wyolum/TinyTiM/README.md

TinyTiM
=======

small brother to TiM
8x8 WS2811 RGB LED Matrix
Data Input can be Serial (1 input - DI_A) or Parallel (8 inputs - DI_A thru' DI_H)
Boards can be daisy-chained in Serial or Parallel Mode (Limited to Power Supply capacity and Microcontroller capability)

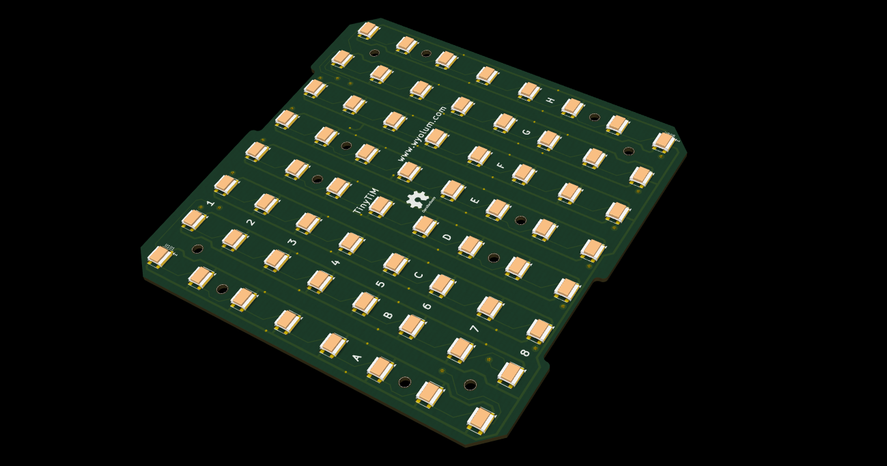
[picture p1: KiCad/rev3/TinyTiM_Images/TinyTiM_rev3_04.png]
TinyTiM top


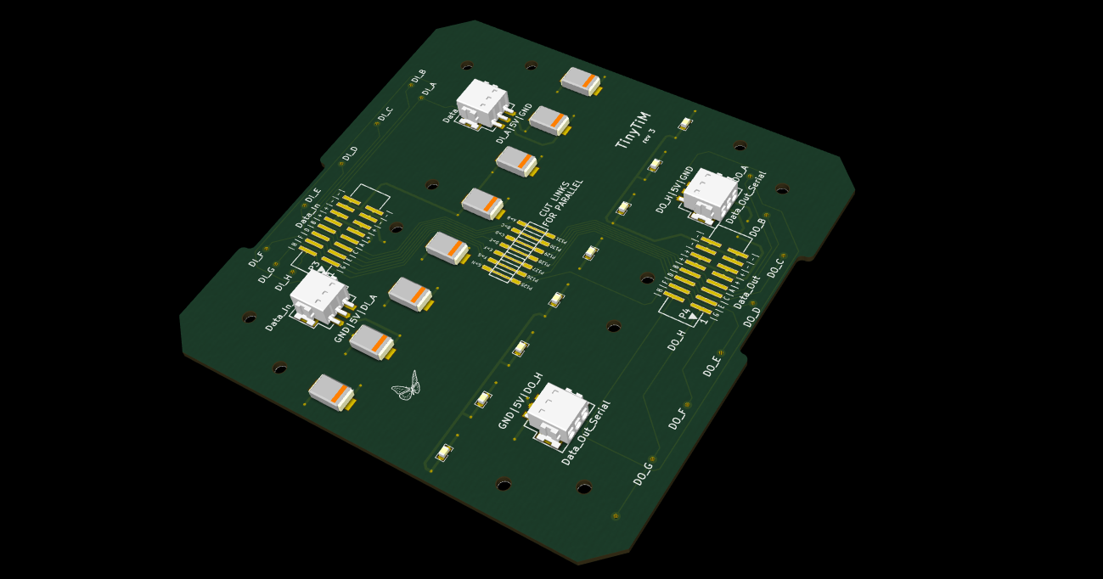
[picture p2: KiCad/rev3/TinyTiM_Images/TinyTiM_rev3_03.png]
TinyTiM bottom


to view 3D render correctly, create a sym_link as follows :

sudo ln -s /home/USER_NAME/projects-git/TinyTiM/KiCad/TinyTiM_3D /usr/share/kicad/modules/packages3d

License
-------
[CERN Open Hardware Licence v1.2 ]

[CERN Open Hardware Licence v1.2 ]:http://www.ohwr.org/attachments/2388/cern_ohl_v_1_2.txt
