wyolum/TinyTiM/KiCad/uTiM/PCB Technology Requirement Format V1 for TinyTim_rev3.xlsx

深圳矽递科技有限公司 Seeed Technology Limited
PCB Technology Requirement Format
PCB Name & Version | TinyTim_rev3
PCB Material PCB板材： | (Rigid)FR－4
PCB Size PCB大小： | inch | ( 4.80 ) × (4.80 )
PCB Layer PCB层数： | 2
Thickness PCB厚度：
 | 1mm
Copper Weight 铜厚： |  | 2oz
PCB Colour 阻焊颜色：
 |  |  | other:( CLEAR )
Silkscreen 字符颜色： |  | Black 黑色 | other:( )
Pads Finished 焊盘喷镀： | (Hasl-lead free) 无铅喷锡
Via solder mask 阻焊覆盖： |  | solder mask opening 过孔开窗
Minimum trace/space (mm) 最小线宽 |  | Minimum hole size (mm) 最小孔径
Special requirements 特殊工艺： | Yes | (Put requirements here)
Comment: | NOTE : SILK SCREEN is ONLY on BOTTOM Layer. FRONT Layer NO SILKSCREEN
