wyolum/TinyTiM/KiCad/rev2/PCB Technology Requirement Format V1 for TinyTim.xlsx

深圳矽递科技有限公司 Seeed Technology Limited
PCB Technology Requirement Format
PCB Name & Version | Tiny Tim
PCB Material PCB板材： | (Rigid)FR－4 | Flex
PCB Size PCB大小： | cm mm inch | ( ) × ( )
PCB Layer PCB层数： | 2 | 4 | other:( )
Thickness PCB厚度： | 0.8mm | 1.2mm | other:( )
 | 1mm | 1.6mm
Copper Weight 铜厚： | 1oz | 2oz | other:( )
PCB Colour 阻焊颜色： | Green 绿色 | White 白色 | Black 黑色
 | Red 红色 | Blue 蓝色 | other:( )
Silkscreen 字符颜色： | White 白色 | Black 黑色 | other:( )
Pads Finished 焊盘喷镀： | (Hasl-lead free) 无铅喷锡 | (Hasl) 含铅喷锡 | (ENIG) 沉镍金
Via solder mask 阻焊覆盖： | solder mask cover 过孔盖油 | solder mask opening 过孔开窗
Minimum trace/space (mm) 最小线宽 |  | Minimum hole size (mm) 最小孔径
Special requirements 特殊工艺： | Yes | (Put requirements here)
Comment:
