wyolum/TinyTiM/KiCad/uTiM/TinyTiM_BOM_sch.csv

Reference | Value | Footprint | Datasheet | Field4 | Field5 | Field6 | manf# | Field7 | Field8 | Field9 | Field10 | Field11
L101 | OSHW | TinyTiM_Lib:OSHW_6mm
L102 | Wyolum | TinyTiM_Libs:logo_wyo_butterfly
P1 | Input1 | TinyTiM_Libs:header_3pos_smd_male |  | CONN HEADER 50POS .100" SGL GOLD | Header | Unshrouded | Male pin |  | 0.1"
P2 | Output1 | TinyTiM_Libs:header_3pos_smd_male |  | CONN HEADER 50POS .100" SGL GOLD | Header | Unshrouded | Male pin |  | 0.1"
P5 | Input2 | TinyTiM_Libs:header_3pos_smd_male |  | CONN HEADER 50POS .100" SGL GOLD | Header | Unshrouded | Male pin |  | 0.1"
P6 | Output2 | TinyTiM_Libs:header_3pos_smd_male |  | CONN HEADER 50POS .100" SGL GOLD | Header | Unshrouded | Male pin |  | 0.1"
P3 | 5V | TinyTiM_Libs:PowerIn_stud |  |  |  |  | mfr_pn
P4 | GND | TinyTiM_Libs:PowerIn_stud |  |  |  |  | mfr_pn
L103 | Maniacal Labs | TinyTiM_Libs:logo_MLlabs
U57 | APA102 | TinyTiM_Libs:APA102 |  |  |  |  | mfr_pn
C3 | 100n | TinyTiM_Libs:c_0805 |  | CAP CER 0.1UF 25V 10% X7R 0805 | 100nF | 25V | Surface Mount | MLCC | Value | Kemet | C0805C104K3RACTU | Digikey | 399-1168-1-ND | http://www.digikey.com/product-detail/en/C0805C104K3RACTU/399-1168-1-ND/411443
C4 | 47u | 8V | TinyTiM_Libs:c_2917 |  | CAP ALUM 47UF 8V 20% SMD | 47u | 8V | 2917 (7343 Metric) | Value | Panasonic Electronic Components | EEF-CD0K470R | Digikey | PCE3606CT-ND | http://www.digikey.com/product-detail/en/EEF-CD0K470R/PCE3606CT-ND/614442
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
U04 | APA102 | TinyTiM_Libs:APA102 |  |  |  |  | mfr_pn
U05 | APA102 | TinyTiM_Libs:APA102 |  |  |  |  | mfr_pn
U06 | APA102 | TinyTiM_Libs:APA102 |  |  |  |  | mfr_pn
U07 | APA102 | TinyTiM_Libs:APA102 |  |  |  |  | mfr_pn
U08 | APA102 | TinyTiM_Libs:APA102 |  |  |  |  | mfr_pn
