wyolum/TinyTiM/KiCad/uTiM/TinyTiM_BoM_rev3.ods

Sheet: BoM_PCB
Id | Value | Reference | Quantity | Package | Supplier and ref
1 | 100n | C101,C201,C301,C401,C501,C601,C701,C801 | 8 | TinyTiM_Lib:c_0805
2 | 47u,8V | C117,C217,C317,C417,C517,C617,C717,C817 | 8 | TinyTiM_Lib:c_2917
5 | Data_In_Serial | P5 | 1 | TinyTiM_Lib:Conn_x3_PTSM
6 | Data_Out_Serial | P6 | 1 | TinyTiM_Lib:Conn_x3_PTSM
7 | Data_In_Serial | P1 | 1 | TinyTiM_Lib:Conn_x2_PTSM
8 | Data_Out_Serial | P2 | 1 | TinyTiM_Lib:Conn_x2_PTSM
20 | RGB_WS2811B | U808,U807,U806,U805,U804,U803,U802,U801,U708,U707,U706,U705,U704,U703,U702,U701,U608,U607,U606,U605,U604,U603,U602,U601,U508,U507,U506,U505,U504,U503,U502,U501,U408,U407,U406,U405,U404,U403,U402,U401,U308,U307,U306,U305,U304,U303,U302,U301,U208,U207,U206,U205,U204,U203,U202,U201,U108,U107,U106,U105,U104,U103,U102,U101 | 64 | TinyTiM_Lib:RGB_WS2811
3 | Wyolum | L102 | 1 | TinyTiM_Lib:Logo-WL3
4 | OSHW | L101 | 1 | TinyTiM_Lib:OSHW_6mm
11 | G>H | P125 | 1 | TinyTiM_Lib:ShortLink2
12 | F>G | P126 | 1 | TinyTiM_Lib:ShortLink2
13 | E>F | P127 | 1 | TinyTiM_Lib:ShortLink2
14 | D>E | P128 | 1 | TinyTiM_Lib:ShortLink2
15 | C>D | P129 | 1 | TinyTiM_Lib:ShortLink2
16 | B>C | P130 | 1 | TinyTiM_Lib:ShortLink2
17 | A>B | P131 | 1 | TinyTiM_Lib:ShortLink2
18 | CONN_1 | PCB101 | 1 | TinyTiM_Lib:PCB
19 | CONN_1 | S101,S102,S401,S402,S501,S502,S801,S802,S103,S104,S803,S804 | 12 | TinyTiM_Lib:Screw
9 | Data_In | P3 | 1 | TinyTiM_Lib:Header_8x2
10 | Data_Out | P4 | 1 | TinyTiM_Lib:Header_8x2

Sheet: BoM_SCH
Id | Value | Reference | Quantity
1 | 100n | C101 C201 C301 C401 C501 C601 C701 C801 | 8
2 | 47u,8V | C117 C217 C317 C417 C517 C617 C717 C817 | 8
5 | Data_In_Serial | P5 | 1
6 | Data_Out_Serial | P6 | 1
7 | Data_In_Serial | P1 | 1
8 | Data_Out_Serial | P2 | 1
9 | Data_In | P3 | 1
10 | Data_Out | P4 | 1
20 | RGB_WS2811B | U101 U102 U103 U104 U105 U106 U107 U108 U201 U202 U203 U204 U205 U206 U207 U208 U301 U302 U303 U304 U305 U306 U307 U308 U401 U402 U403 U404 U405 U406 U407 U408 U501 U502 U503 U504 U505 U506 U507 U508 U601 U602 U603 U604 U605 U606 U607 U608 U701 U702 U703 U704 U705 U706 U707 U708 U801 U802 U803 U804 U805 U806 U807 U808 | 64
3 | Wyolum | L102 | 1
4 | OSHW | L101 | 1
11 | G>H | P125 | 1
12 | F>G | P126 | 1
13 | E>F | P127 | 1
14 | D>E | P128 | 1
15 | C>D | P129 | 1
16 | B>C | P130 | 1
17 | A>B | P131 | 1
18 | CONN_1 | PCB101 | 1
19 | CONN_1 | S101 S102 S103 S104 S401 S402 S501 S502 S801 S802 S803 S804 | 12

Sheet: BoM_TinyTiM
Id | Reference | Quantity | Value
1 | C101 C201 C301 C401 C501 C601 C701 C801 | 8 | 100n
2 | C117 C217 C317 C417 C517 C617 C717 C817 | 8 | 47u,8V
5 | P5 | 1 | Data_In_Serial
6 | P6 | 1 | Data_Out_Serial
7 | P1 | 1 | Data_In_Serial
8 | P2 | 1 | Data_Out_Serial
9 | P3 | 1 | Data_In
10 | P4 | 1 | Data_Out
20 | U101 U102 U103 U104 U105 U106 U107 U108 U201 U202 U203 U204 U205 U206 U207 U208 U301 U302 U303 U304 U305 U306 U307 U308 U401 U402 U403 U404 U405 U406 U407 U408 U501 U502 U503 U504 U505 U506 U507 U508 U601 U602 U603 U604 U605 U606 U607 U608 U701 U702 U703 U704 U705 U706 U707 U708 U801 U802 U803 U804 U805 U806 U807 U808 | 64 | RGB_WS2811B
