wyolum/TinyTiM/KiCad/uTiM/TinyTiM.FCStd

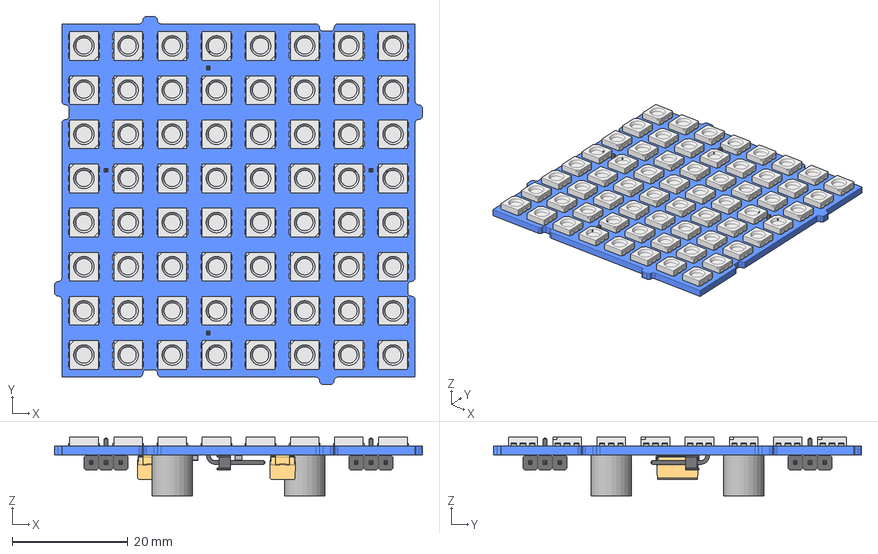
[picture p3: CAD file, 2016-02-17]
KiCad/uTiM/TinyTiM.FCStd
63.5 x 63.5 x 10.1 mm
Pcb
User_Library-CapCeramic_Kemet_0805_2012_
User_Library-CapCeramic_Kemet_0805_2012_001
Draft_
Draft_001
Draft_002
Draft_003
Draft_004
Draft_005
Draft_006
Draft_007
Draft_008
Draft_009
Draft_010
Draft_011
Draft_012
Draft_013
Draft_014
Draft_015
Draft_016
Draft_017
Draft_018
Draft_019
Draft_020
Draft_021
Draft_022
Draft_023
Draft_024
Draft_025
Draft_026
Draft_027
Draft_028
Draft_029
Draft_030
Draft_031
Draft_032
Draft_033
Draft_034
Draft_035
Draft_036
Draft_037
Draft_038
Draft_039
Draft_040
Draft_041
Draft_042
Draft_043
Draft_044
Draft_045
Draft_046
Draft_047
Draft_048
Draft_049
Draft_050
Draft_051
Draft_052
Draft_053
Draft_054
Draft_055
Draft_056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
