wyolum/TinyTiM/KiCad/uTiM/TinyTiM_3D/Cap_2917_AVX_E_CASE.step

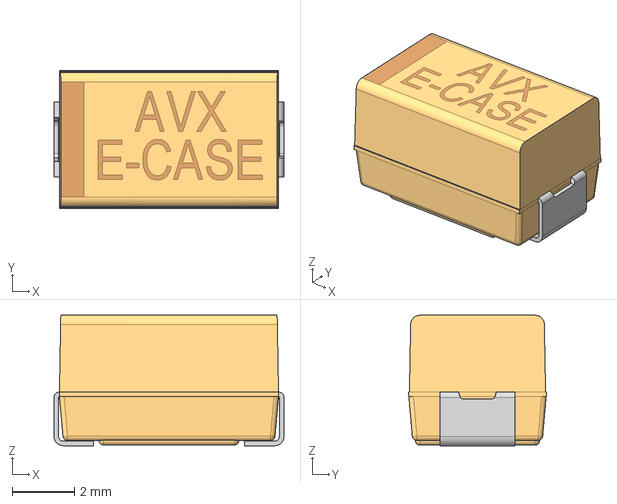
[picture p4: CAD file, 2016-02-17]
KiCad/uTiM/TinyTiM_3D/Cap_2917_AVX_E_CASE.step
7.40 x 4.45 x 4.20 mm
