wyolum/TinyTiM/KiCad/uTiM/TinyTiM1.FCStd

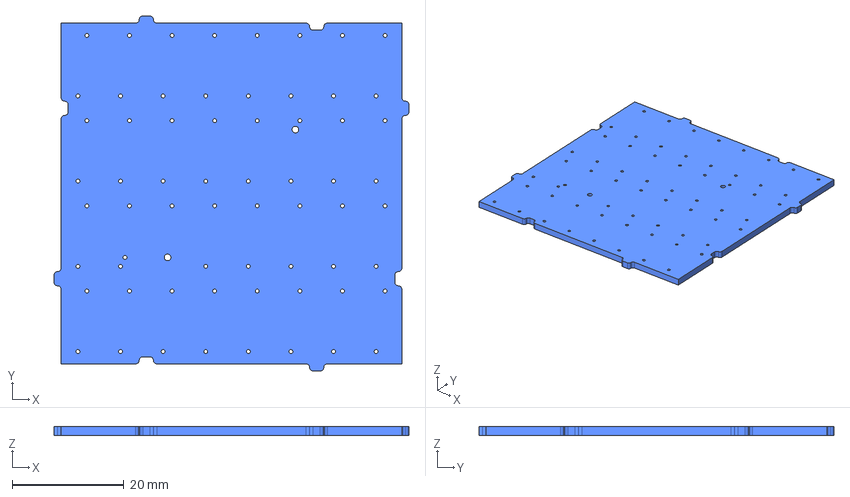
[picture p5: CAD file, 2016-02-17]
KiCad/uTiM/TinyTiM1.FCStd
63.5 x 63.5 x 1.60 mm
