wyolum/TinyTiM/KiCad/uTiM/TinyTiM_3D/header_a-sl200-da-g06mp1.step

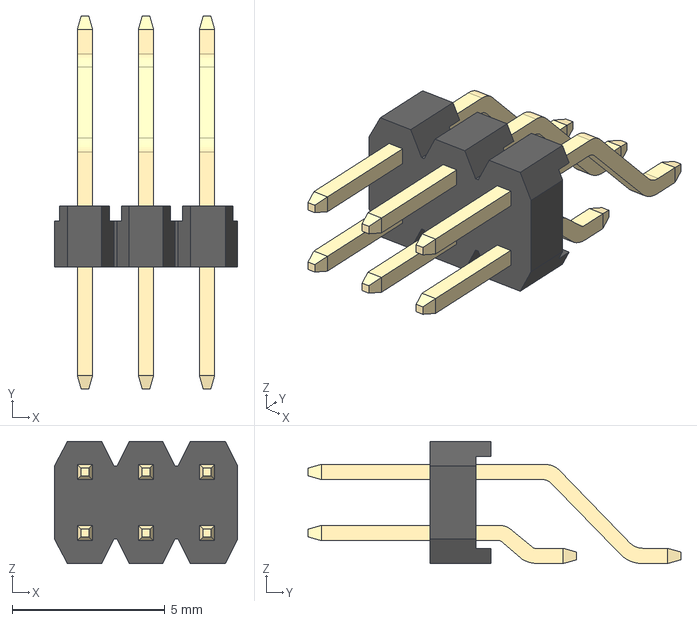
[picture p6: CAD file, 2016-02-16]
KiCad/uTiM/TinyTiM_3D/header_a-sl200-da-g06mp1.step
6.00 x 12.2 x 4.00 mm
