wyolum/TinyTiM/KiCad/uTiM/TinyTiM_3D/header1x3_1241150-3.step

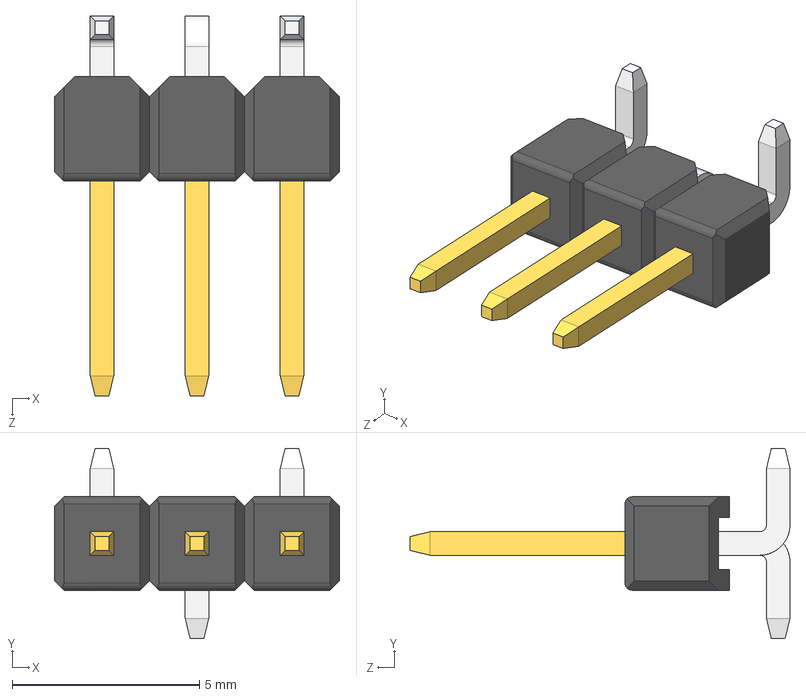
[picture p7: CAD file, 2016-02-16]
KiCad/uTiM/TinyTiM_3D/header1x3_1241150-3.step
7.62 x 5.08 x 10.2 mm
