wyolum/TinyTiM/KiCad/uTiM/TinyTiM_3D/header_Male_RA_Low_3Pin.step

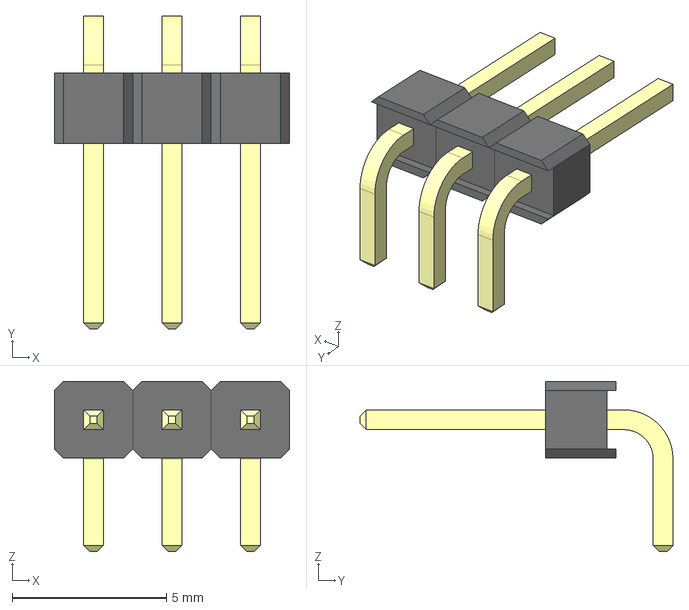
[picture p8: CAD file, 2016-02-16]
KiCad/uTiM/TinyTiM_3D/header_Male_RA_Low_3Pin.step
7.62 x 10.1 x 5.52 mm
