wyolum/TinyTiM/KiCad/uTiM/TinyTiM_3D/BM03B-SRSS-TB.step

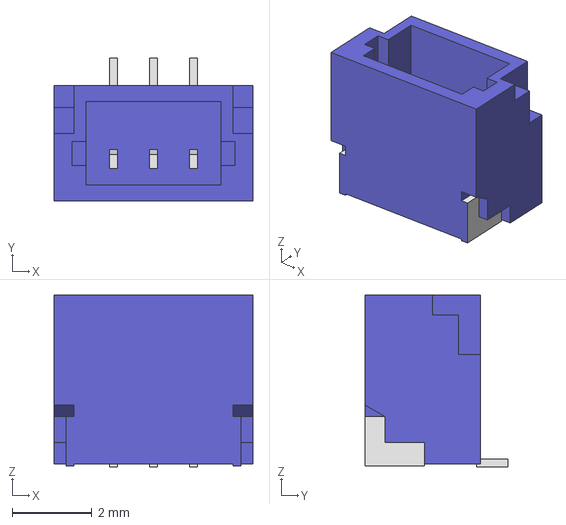
[picture p9: CAD file, 2016-02-15]
KiCad/uTiM/TinyTiM_3D/BM03B-SRSS-TB.step
5.00 x 3.60 x 4.32 mm
