wyolum/TinyTiM/KiCad/uTiM/TinyTiM_3D/PowerIn_Stud.step

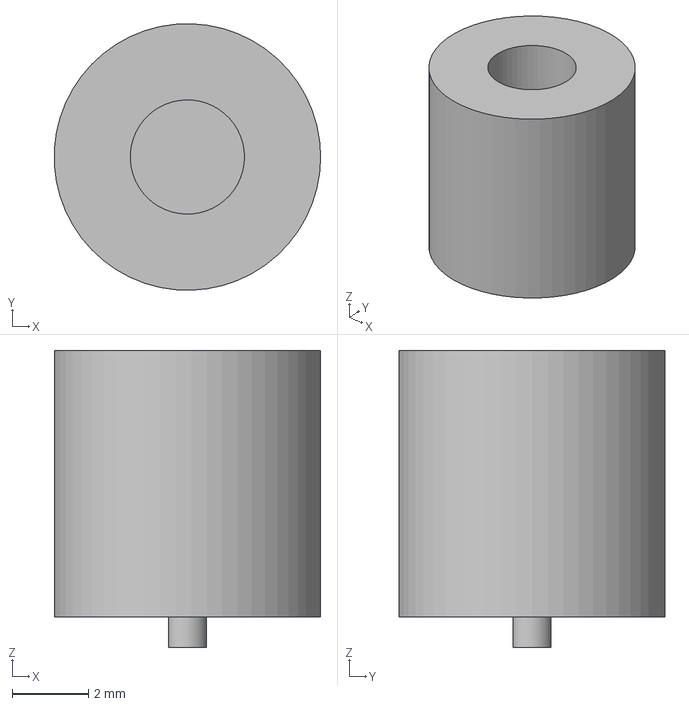
[picture p10: CAD file, 2016-02-15]
KiCad/uTiM/TinyTiM_3D/PowerIn_Stud.step
6.99 x 7.00 x 7.80 mm
