wyolum/TinyTiM/KiCad/uTiM/TinyTiM_3D/Cap_0805_2012.step

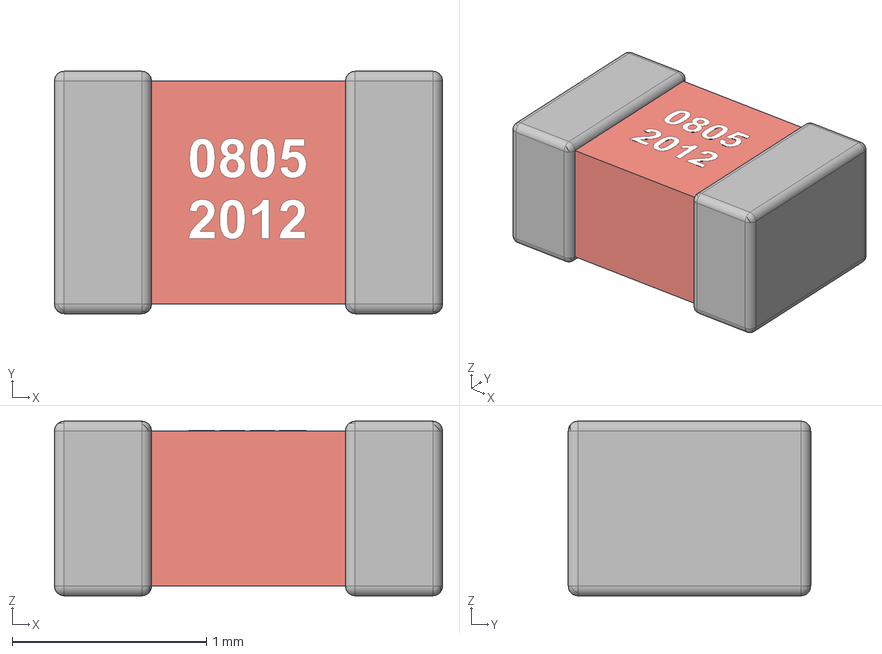
[picture p11: CAD file, 2016-02-15]
KiCad/uTiM/TinyTiM_3D/Cap_0805_2012.step
2.00 x 1.25 x 0.9 mm
