wyolum/TinyTiM/KiCad/uTiM/TinyTiM_3D/LED_SMD_APA102.step

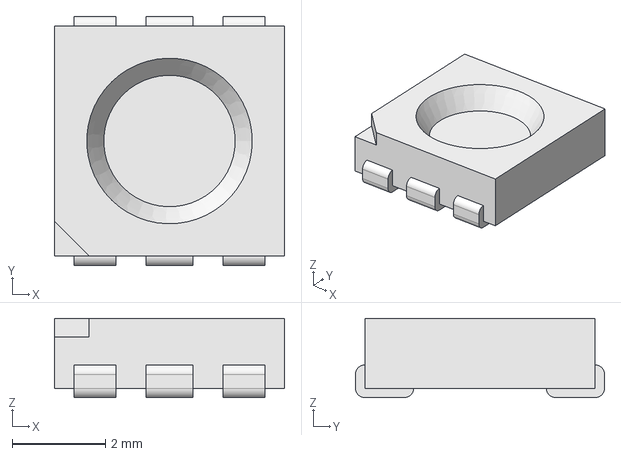
[picture p12: CAD file, 2016-02-15]
KiCad/uTiM/TinyTiM_3D/LED_SMD_APA102.step
4.95 x 5.35 x 1.70 mm
