wyolum/TinyTiM/KiCad/uTiM/TinyTiM_3D/conn_1771033.stp

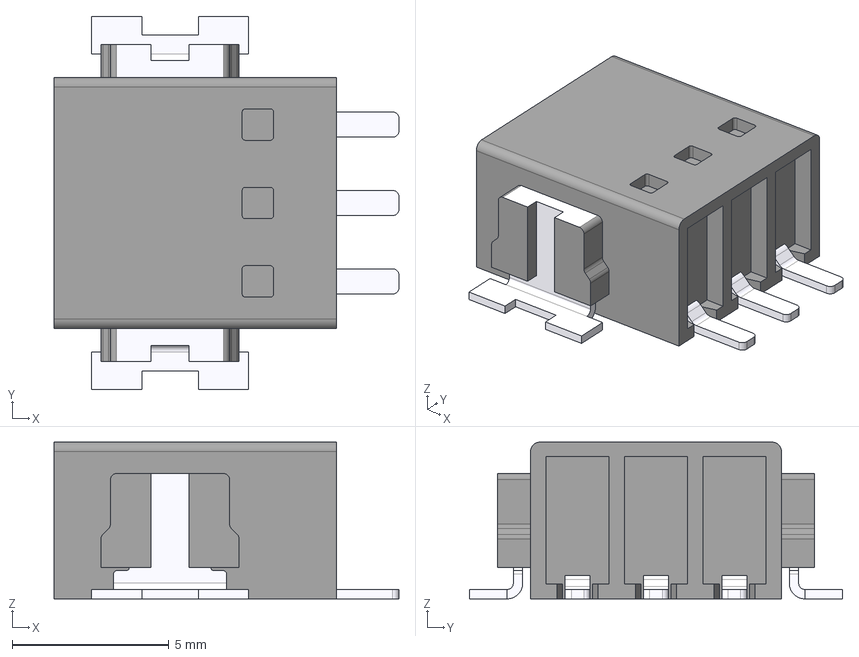
[picture p13: CAD file, 2016-02-15]
KiCad/uTiM/TinyTiM_3D/conn_1771033.stp
11.0 x 11.9 x 5.00 mm
