wyolum/TinyTiM/KiCad/rev1/TinyTiM_3D/User Library-20-pin SMT header.stl

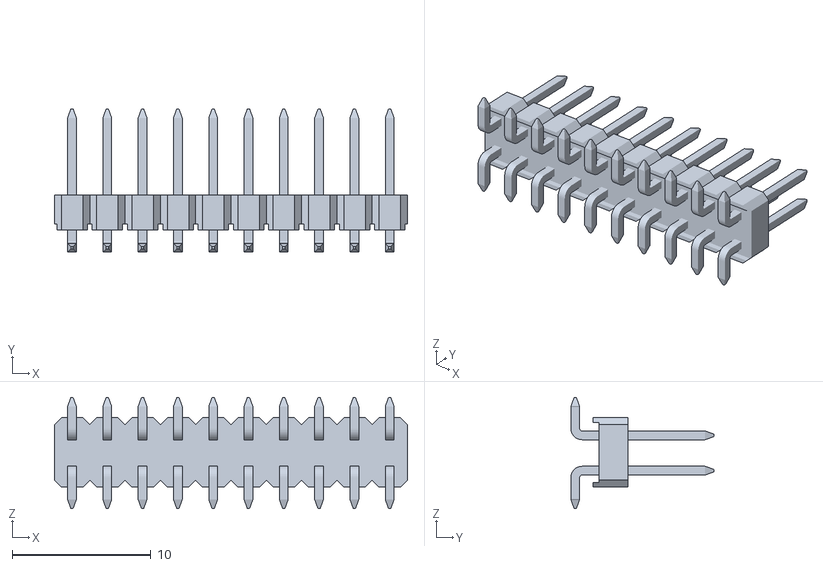
[picture p14: CAD file, 2014-04-24, an earlier design]
KiCad/rev1/TinyTiM_3D/User Library-20-pin SMT header.stl
25.4 x 10.3 x 8.00
