wyolum/TinyTiM/KiCad/rev1/TinyTiM_3D/Male_Header_2x8.stl

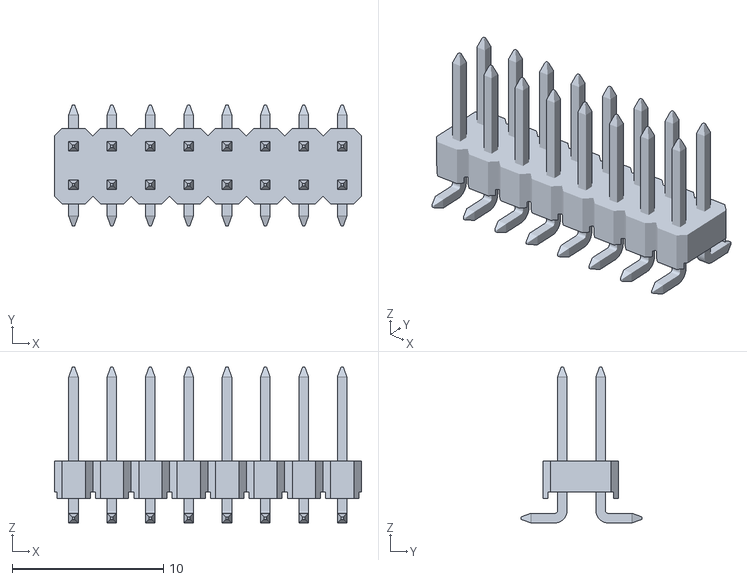
[picture p15: CAD file, 2014-04-24, an earlier design]
KiCad/rev1/TinyTiM_3D/Male_Header_2x8.stl
20.3 x 8.00 x 10.3
