wyolum/TinyTiM/KiCad/rev1/TinyTiM_3D/User Library-M22-2row-female-20pos.stl

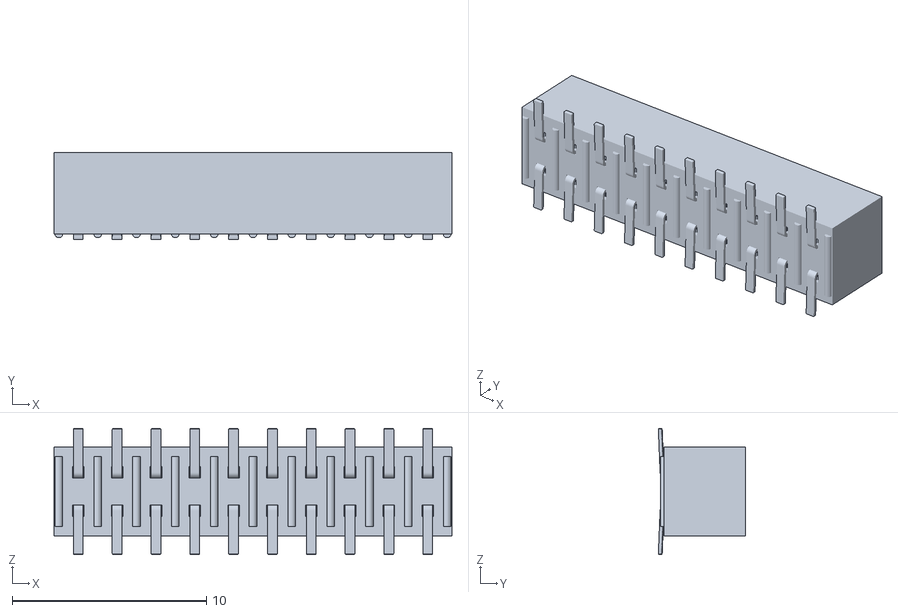
[picture p16: CAD file, 2014-04-24, an earlier design]
KiCad/rev1/TinyTiM_3D/User Library-M22-2row-female-20pos.stl
20.5 x 4.50 x 6.50
