wyolum/TinyTiM/(list of files, cad)

Other CAD files:
KiCad/uTiM/TinyTiM2.step
KiCad/rev2/TinyTiM.iges
KiCad/rev2/TinyTiM.stl
KiCad/uTiM/TinyTiM_3D/PowerIn_Stud.fcstd
