wyolum/TinyTiM/KiCad/uTiM/gerber/TinyTiM.pdf

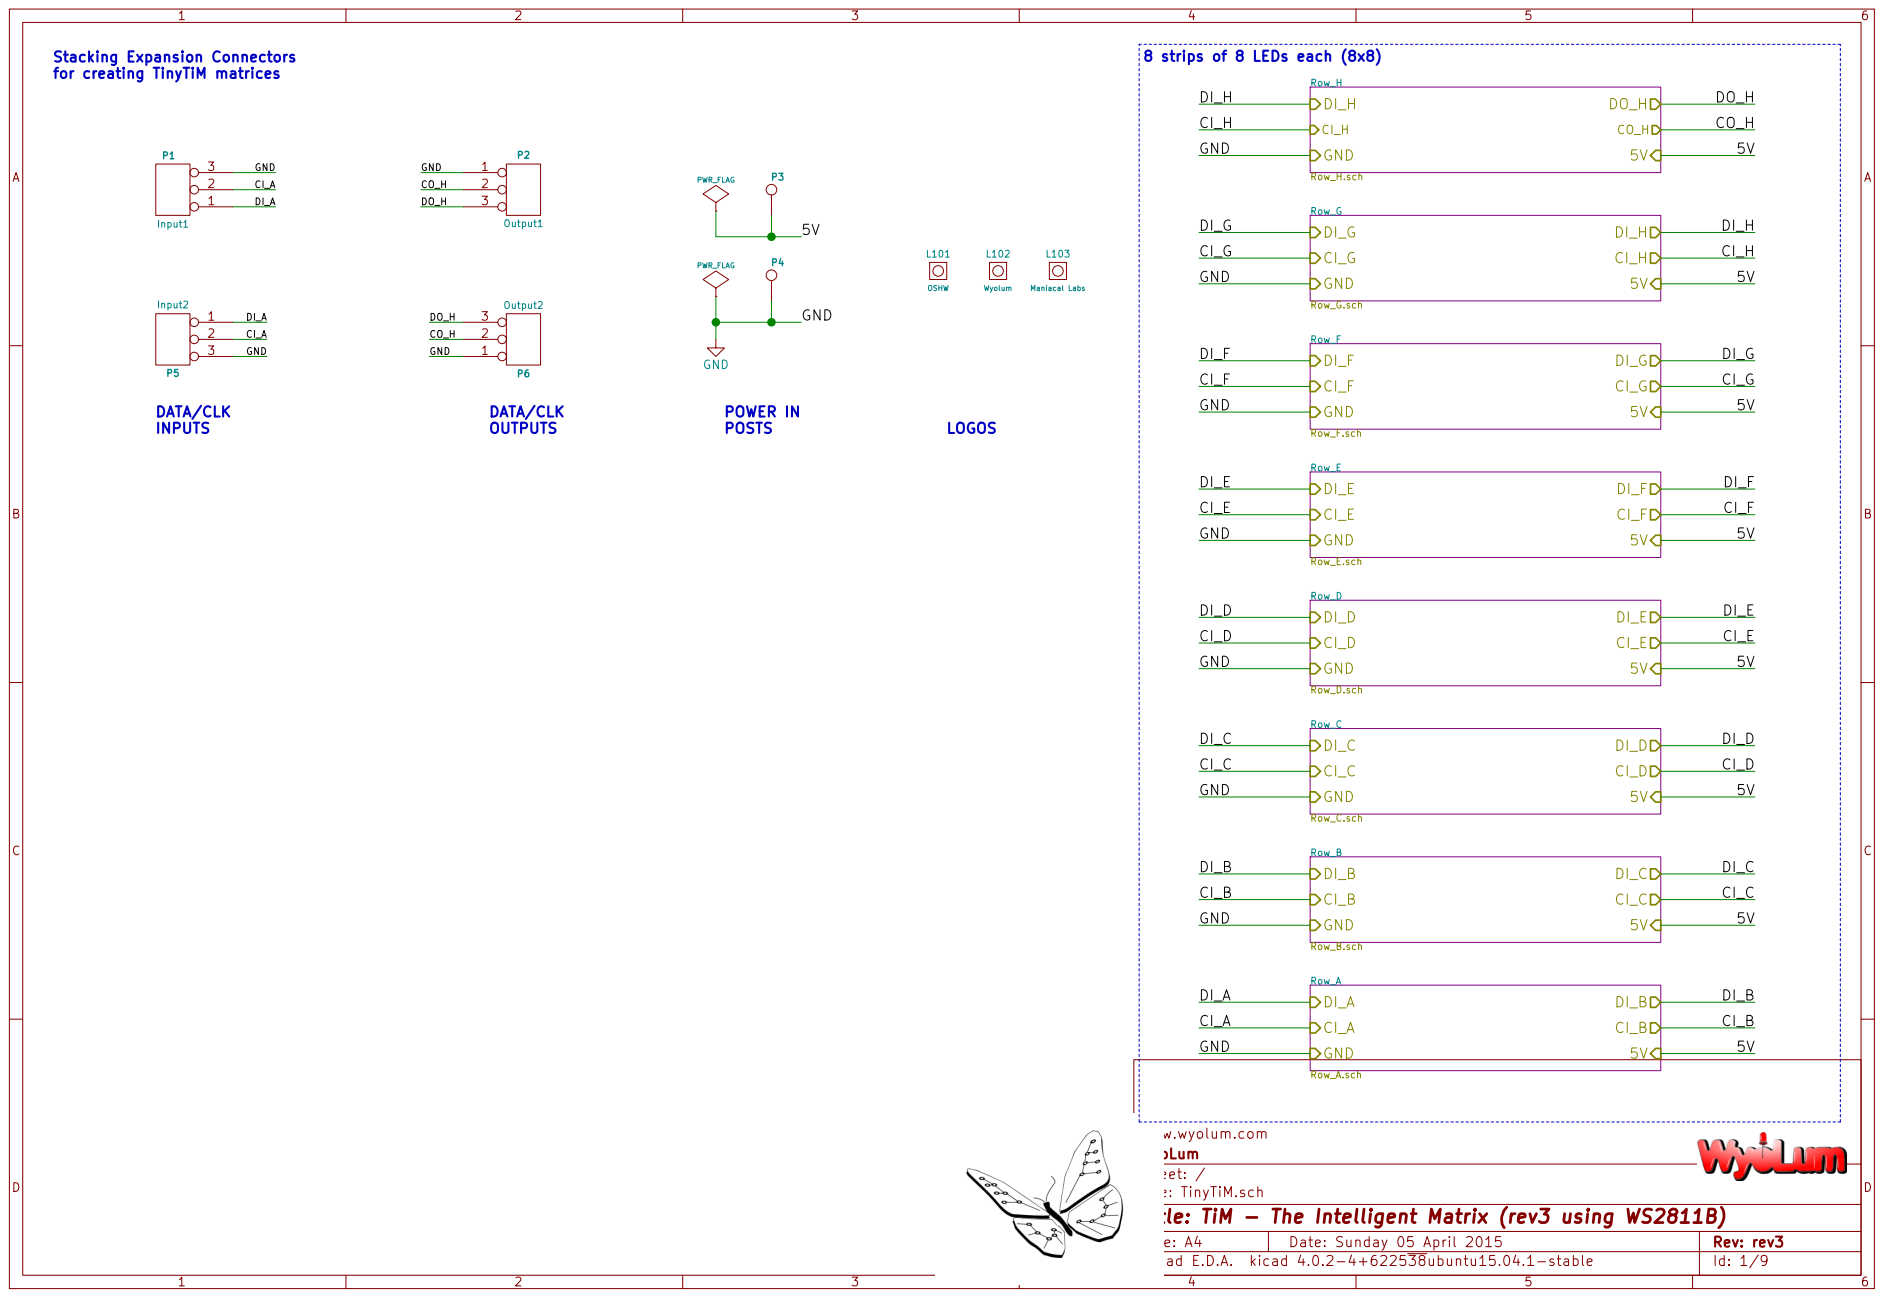
[picture p17: page 1]

L102 Wyolum Stacking Expansion Connectors
for creating TinyTiM matrices

8 strips of 8 LEDs each (8x8) L103 Maniacal Labs

www.wyolum.com
File: TinyTiM.sch Sheet: / WyoLum

Id: 1/9 Title: TiM - The Intelligent Matrix (rev3 using WS2811B)

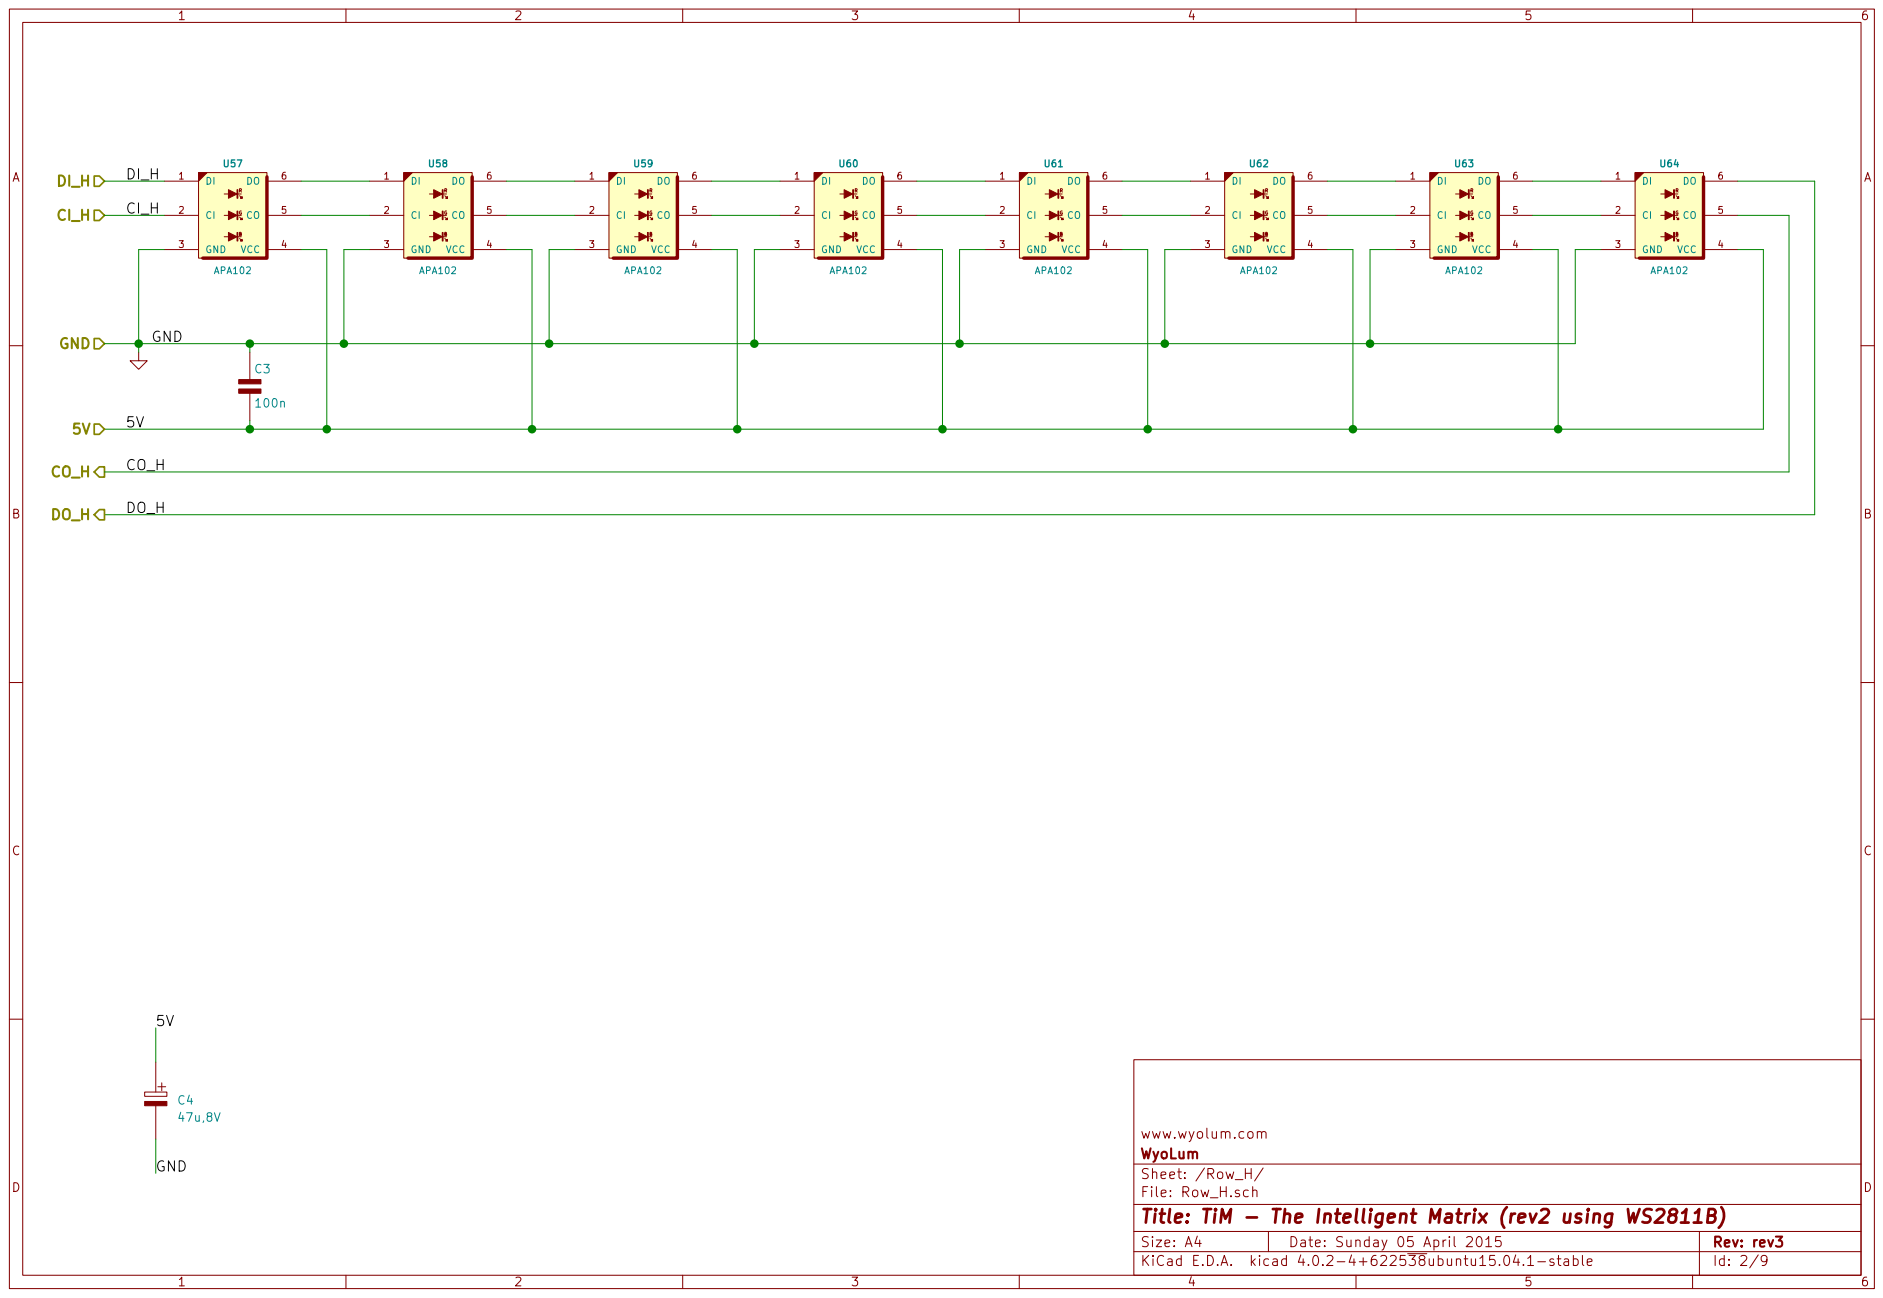
[picture p18: page 2]

www.wyolum.com
WyoLum
Sheet: /Row_H/
File: Row_H.sch
Id: 2/9 Title: TiM - The Intelligent Matrix (rev2 using WS2811B)

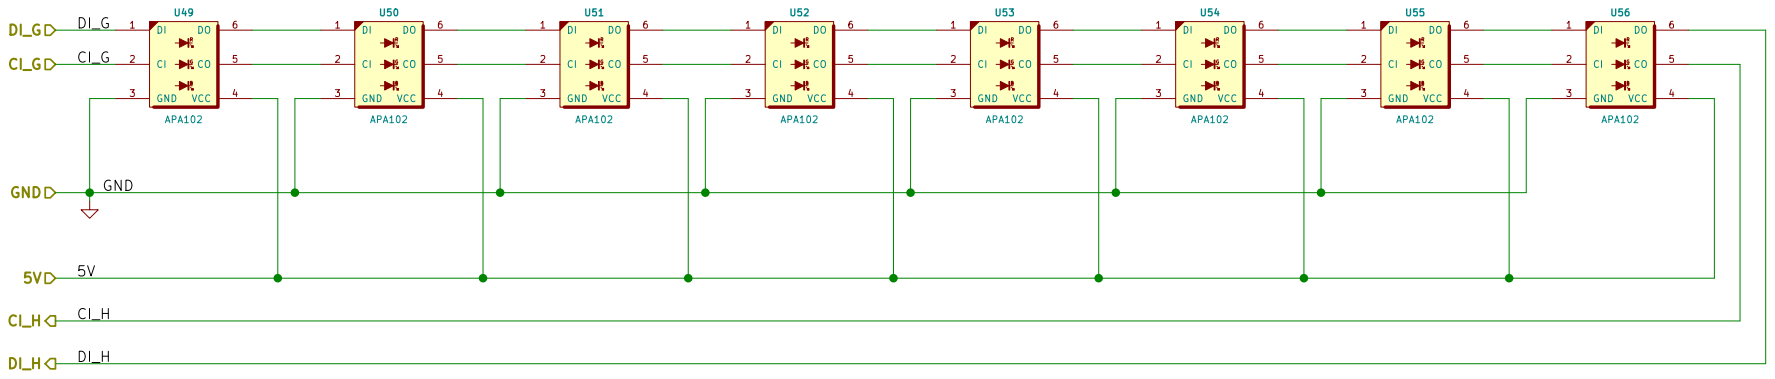
[picture p19: page 3]

www.wyolum.com
WyoLum
Sheet: /Row_G/
File: Row_G.sch
Id: 3/9 Title: TiM - The Intelligent Matrix (rev2 using WS2811B)

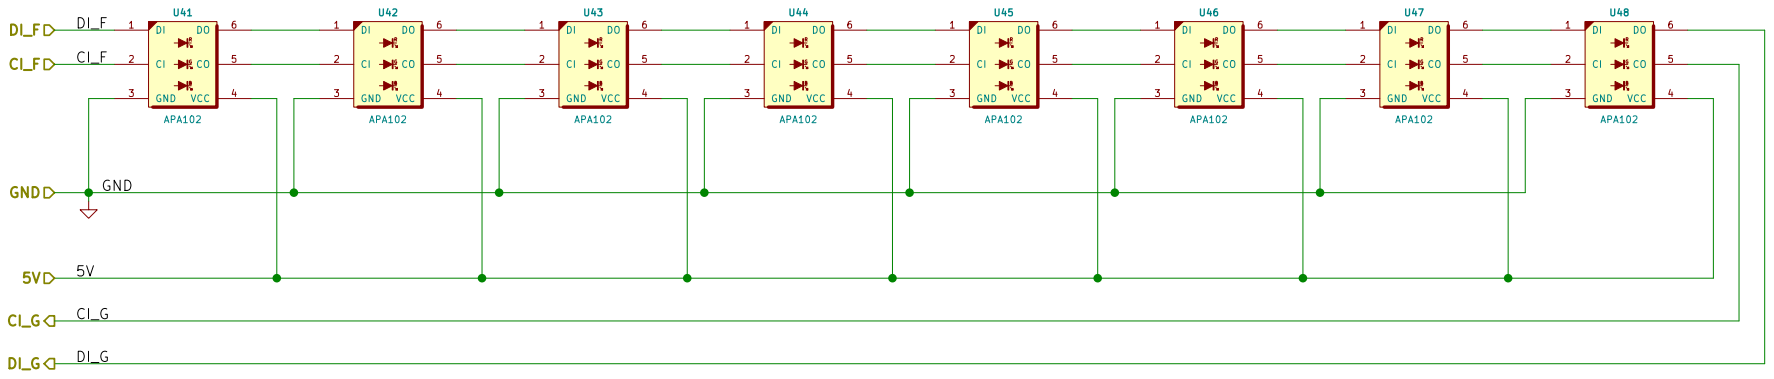
[picture p20: page 4]

www.wyolum.com
WyoLum
Sheet: /Row_F/
File: Row_F.sch
Id: 4/9 Title: TiM - The Intelligent Matrix (rev2 using WS2811B)

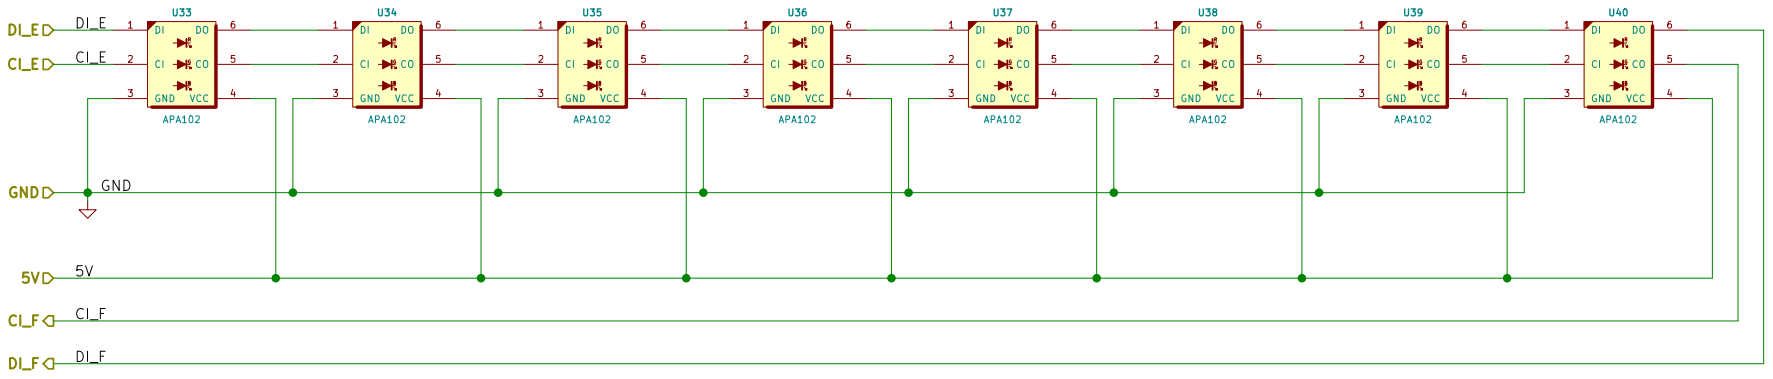
[picture p21: page 5]

www.wyolum.com
WyoLum
Sheet: /Row_E/
File: Row_E.sch
Id: 5/9 Title: TiM - The Intelligent Matrix (rev2 using WS2811B)

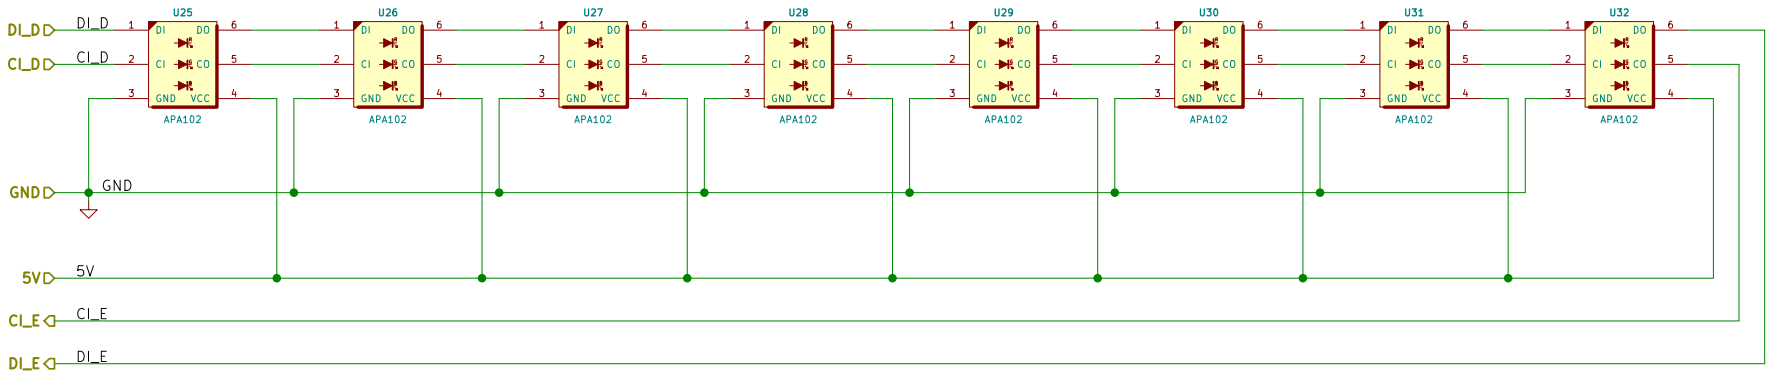
[picture p22: page 6]

www.wyolum.com
WyoLum
Sheet: /Row_D/
File: Row_D.sch
Id: 6/9 Title: TiM - The Intelligent Matrix (rev2 using WS2811B)

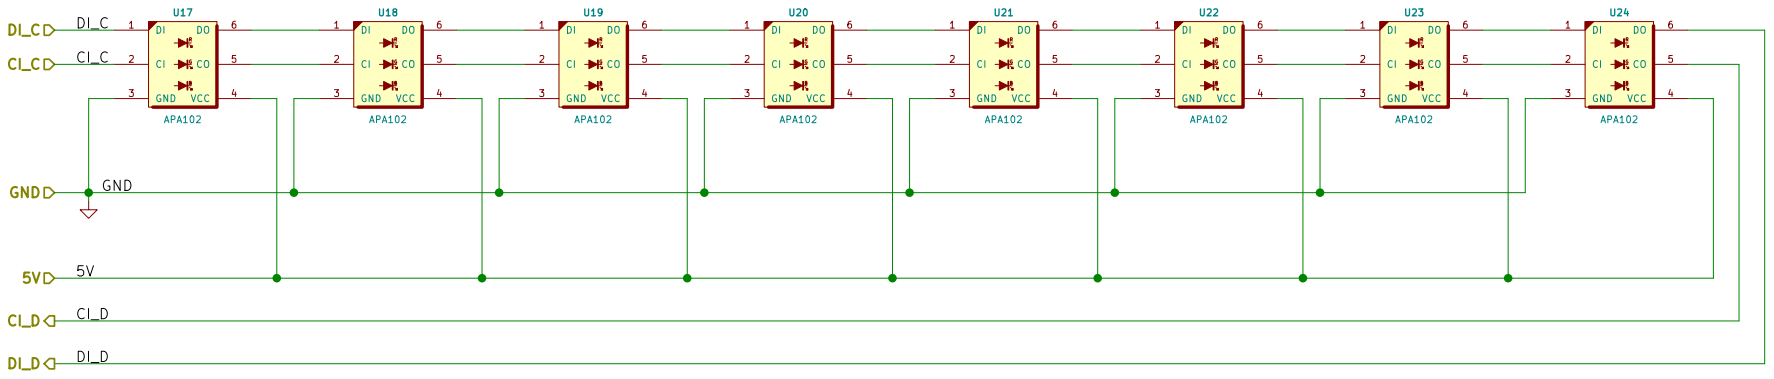
[picture p23: page 7]

www.wyolum.com
WyoLum
Sheet: /Row_C/
File: Row_C.sch
Id: 7/9 Title: TiM - The Intelligent Matrix (rev2 using WS2811B)

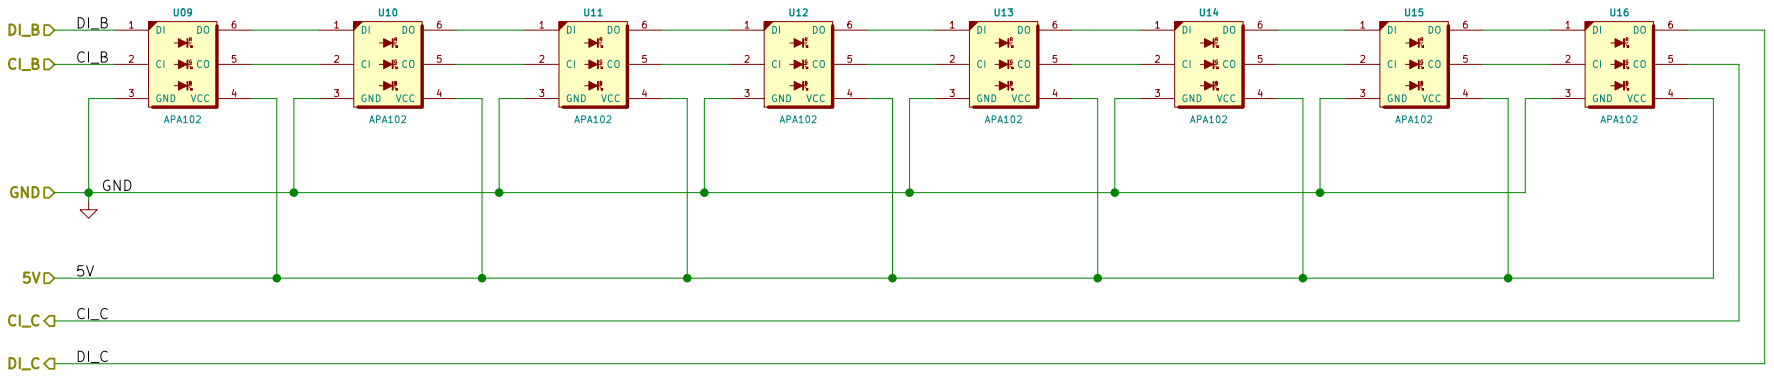
[picture p24: page 8]

www.wyolum.com
WyoLum
Sheet: /Row_B/
File: Row_B.sch
Id: 8/9 Title: TiM - The Intelligent Matrix (rev2 using WS2811B)

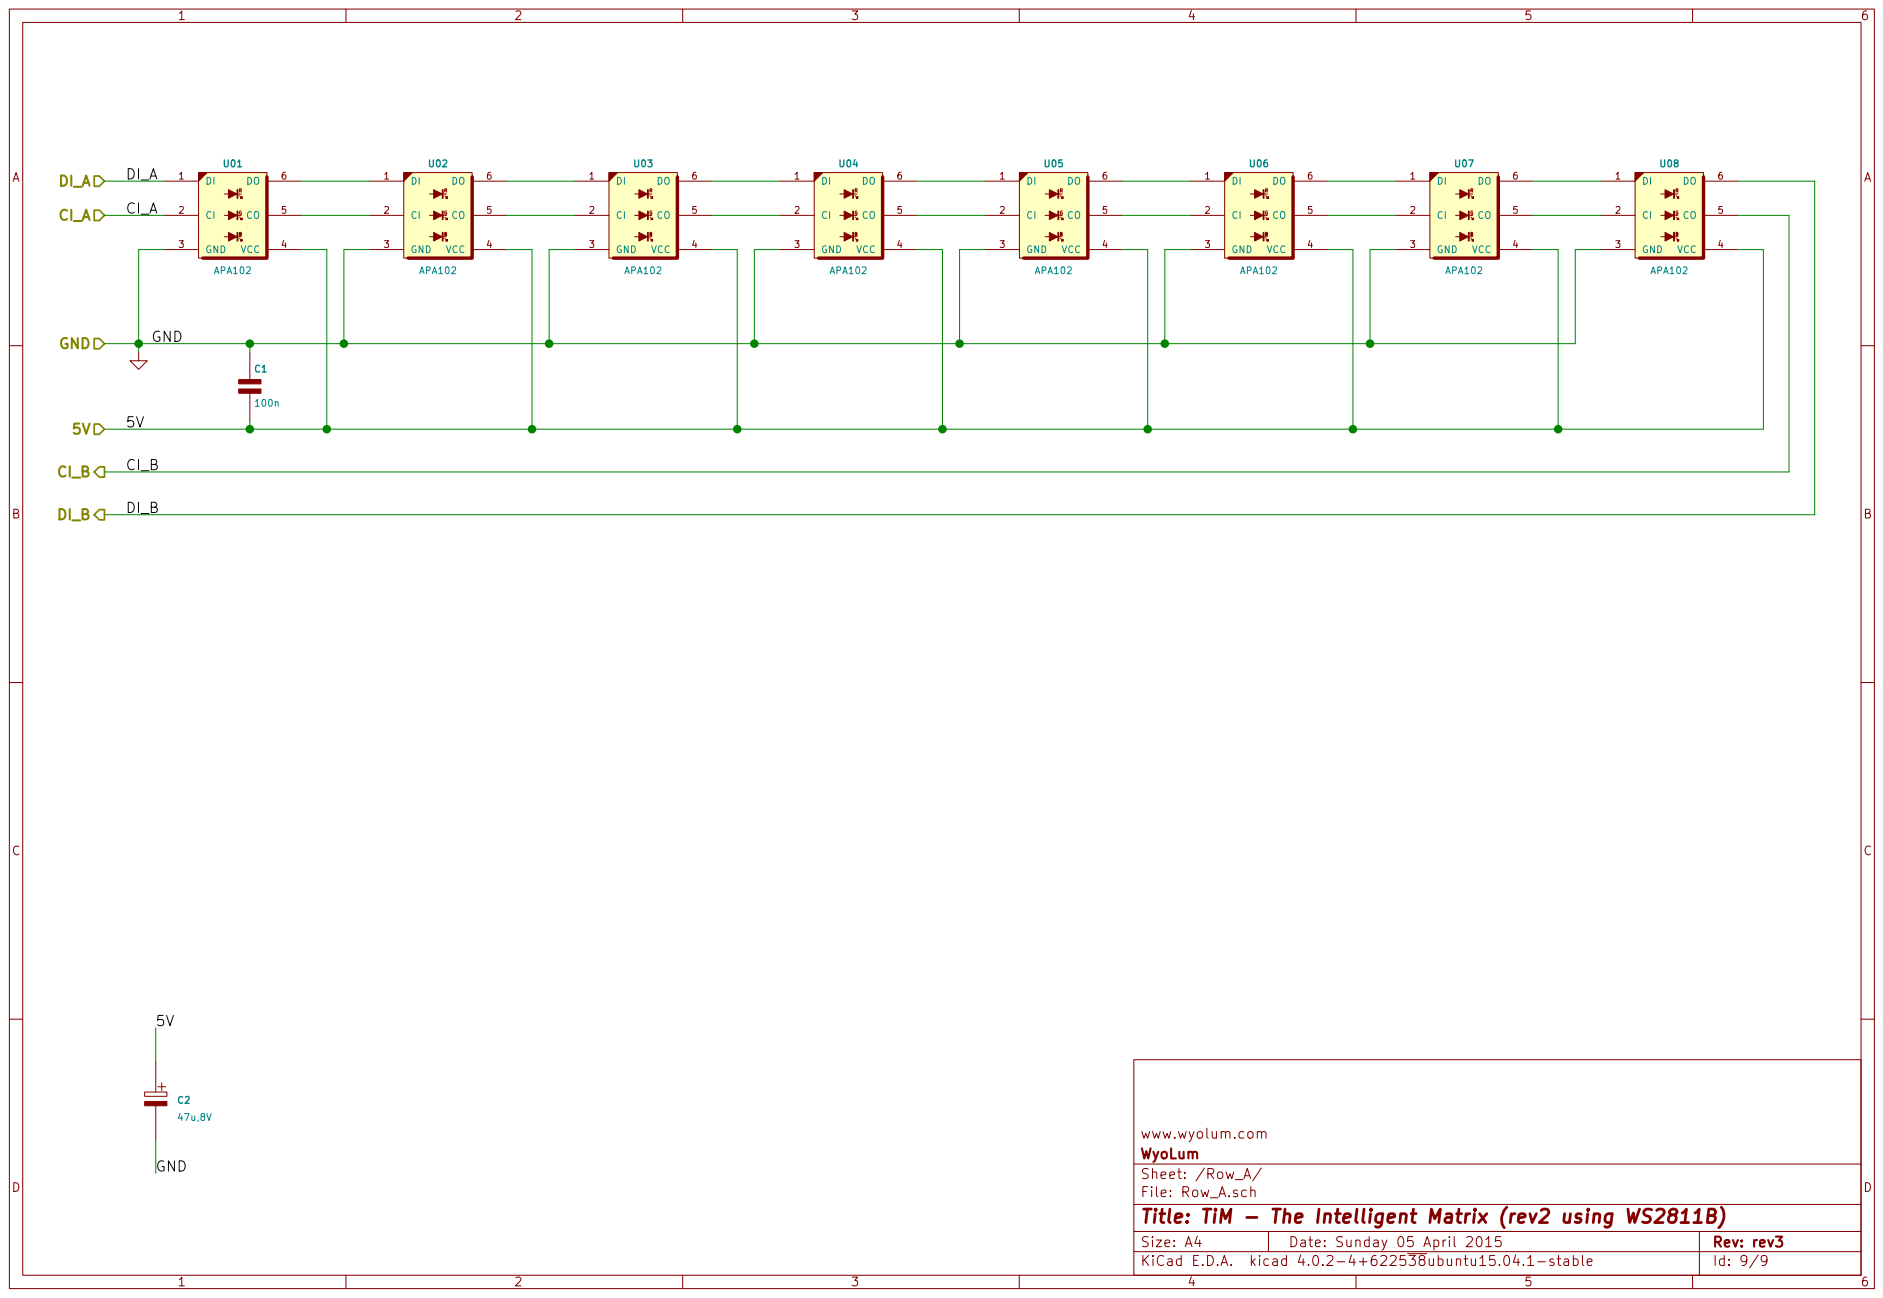
[picture p25: page 9]

www.wyolum.com
WyoLum
Sheet: /Row_A/
File: Row_A.sch
Id: 9/9 Title: TiM - The Intelligent Matrix (rev2 using WS2811B)
