wyolum/TinyTiM/KiCad/rev2/TinyTiM.pdf

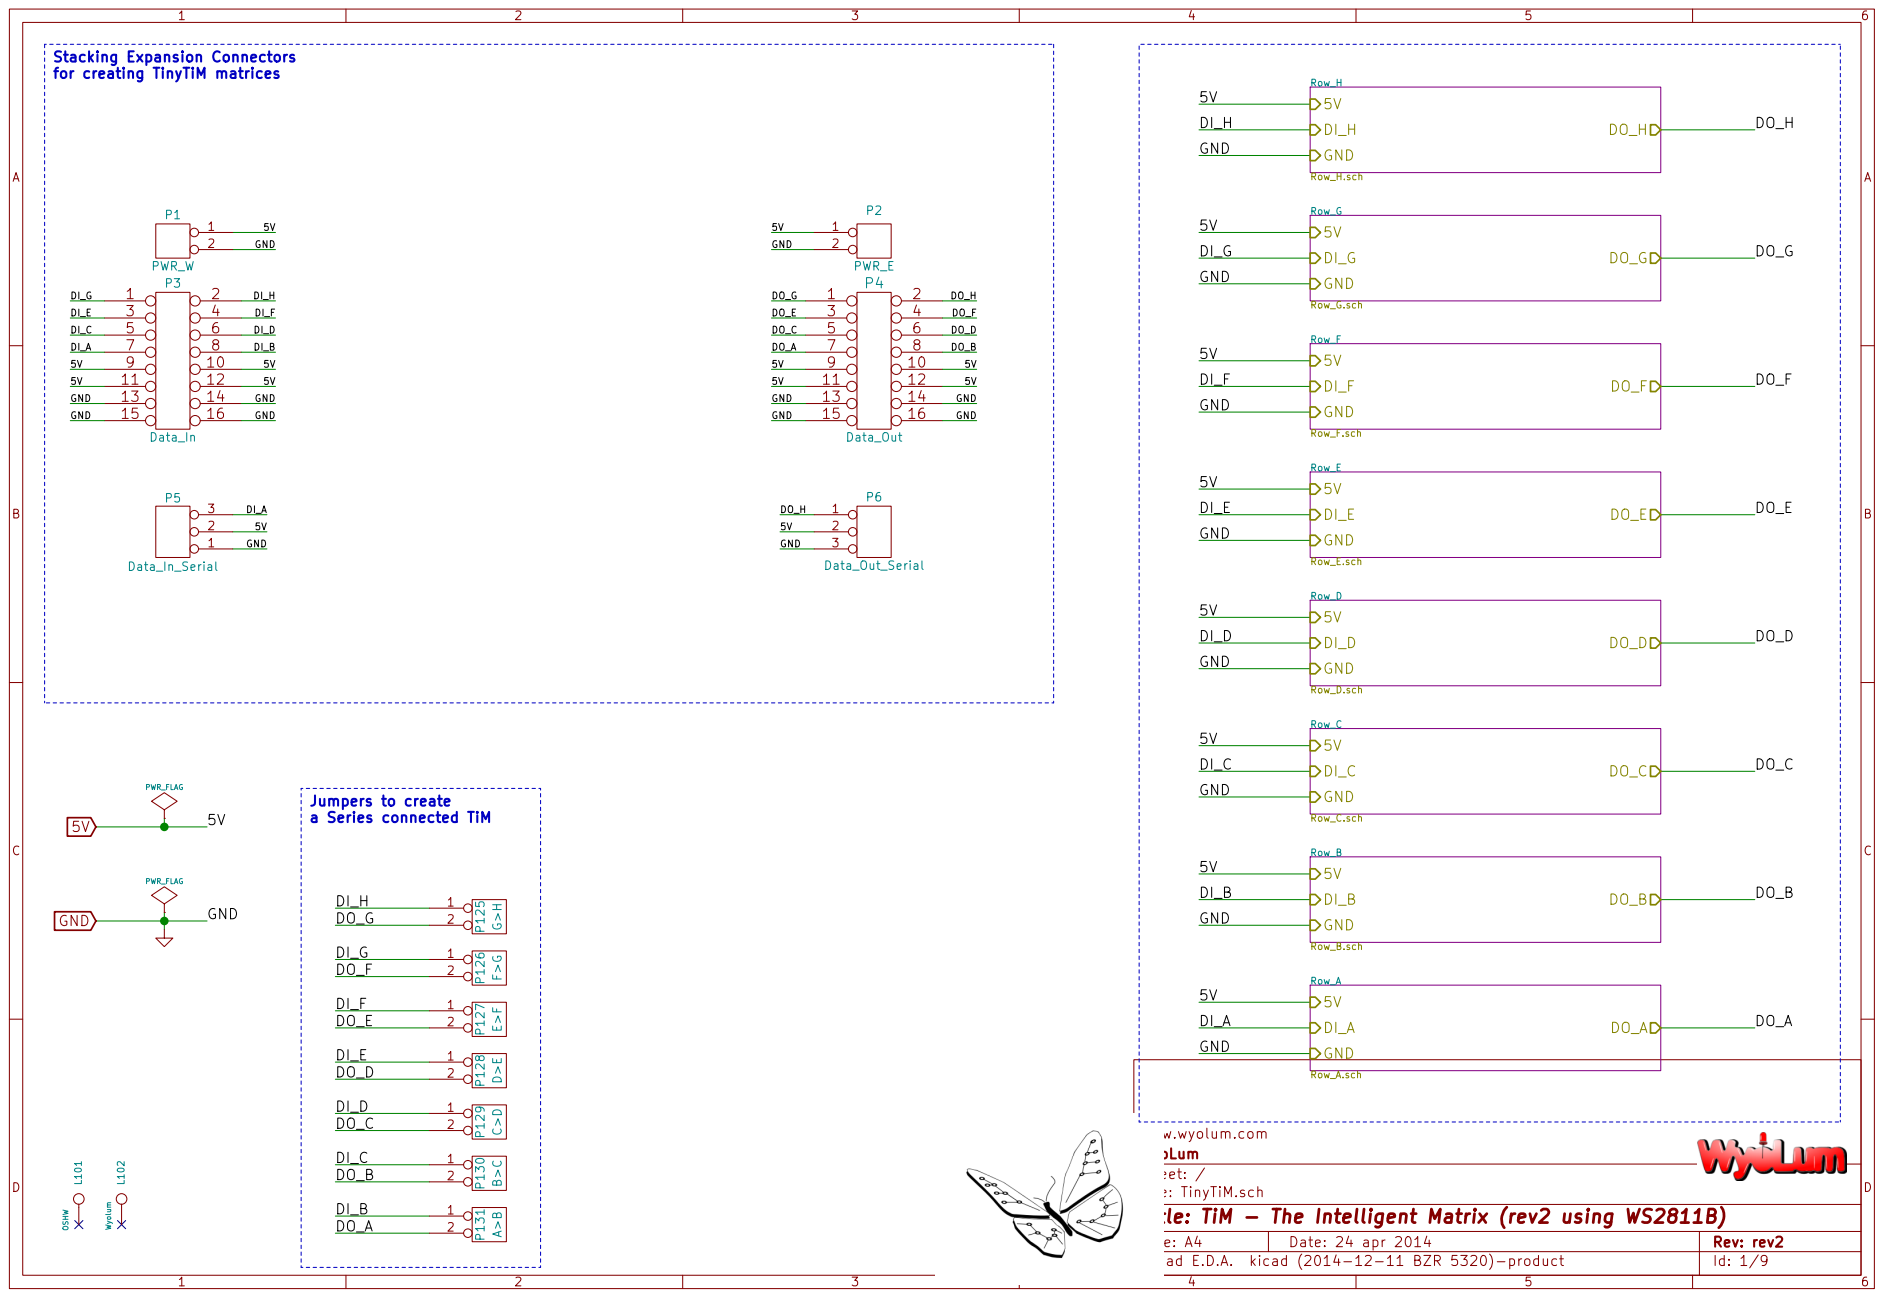
[picture p26: page 1]

File: TinyTiM.sch Sheet: / WyoLum

Id: 1/9 Title: TiM - The Intelligent Matrix (rev2 using WS2811B)

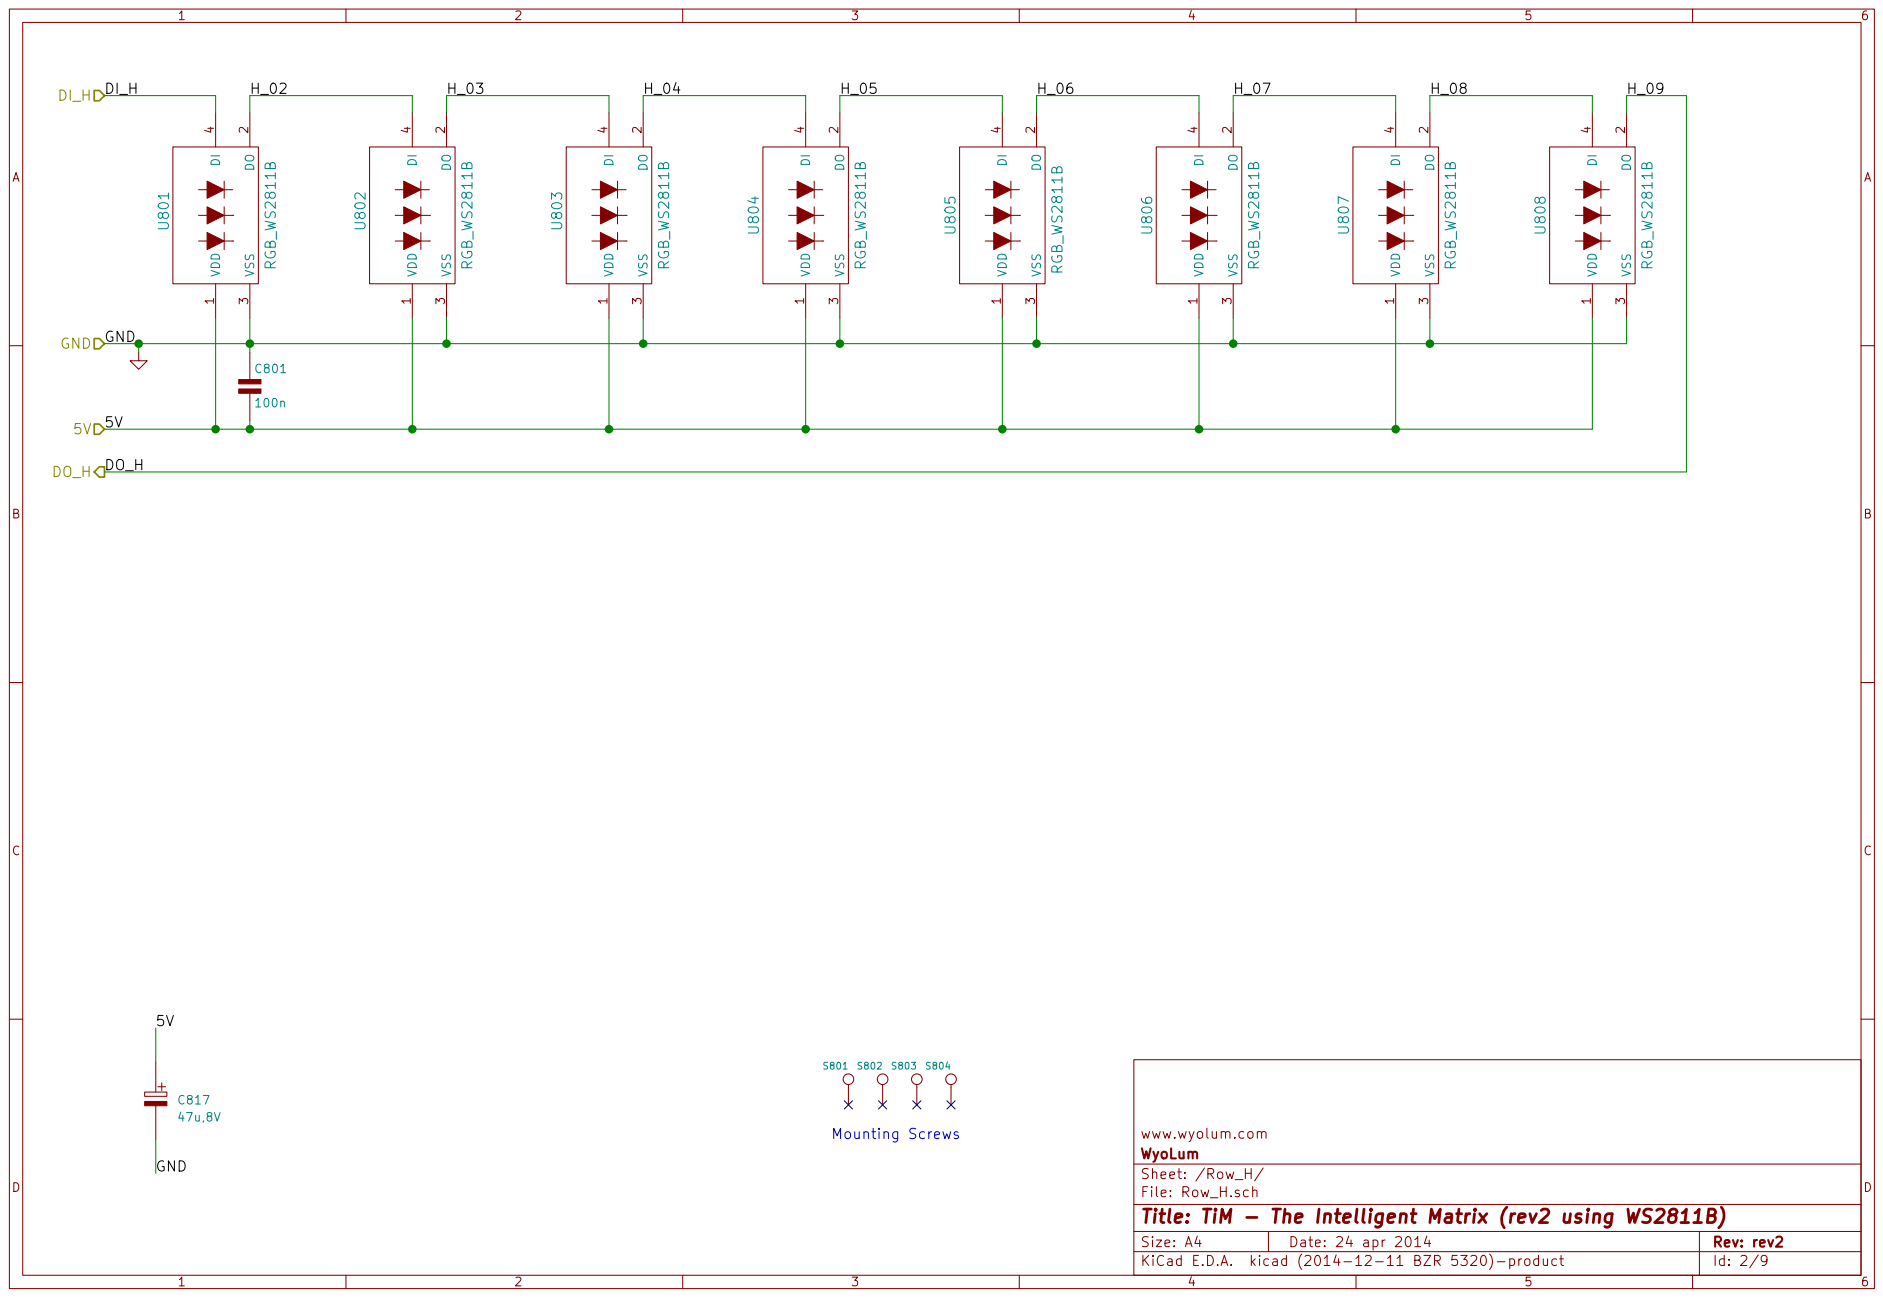
[picture p27: page 2]

www.wyolum.com
WyoLum
Sheet: /Row_H/
File: Row_H.sch
Id: 2/9 Title: TiM - The Intelligent Matrix (rev2 using WS2811B)

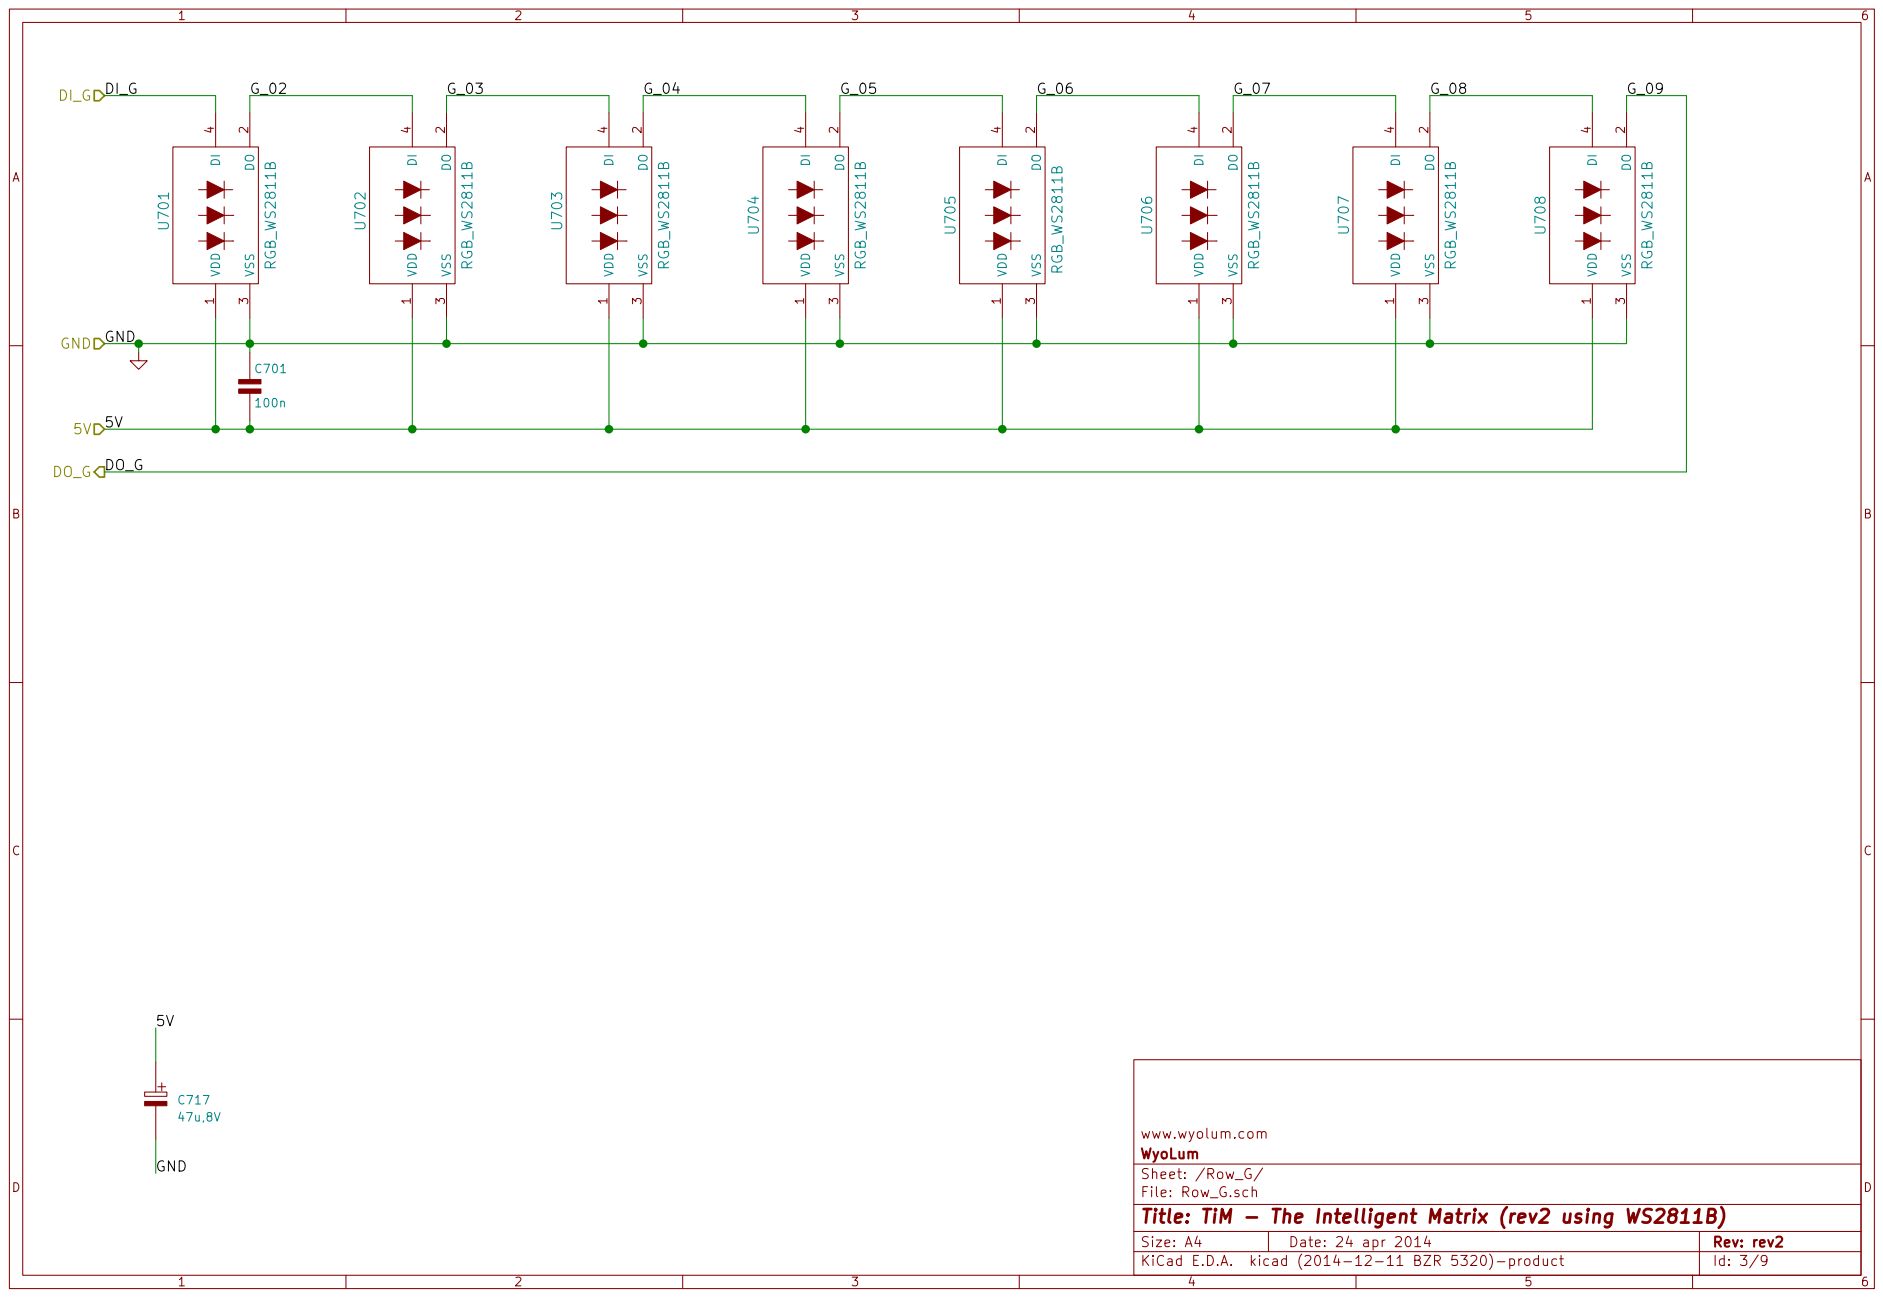
[picture p28: page 3]

www.wyolum.com
WyoLum
Sheet: /Row_G/
File: Row_G.sch
Id: 3/9 Title: TiM - The Intelligent Matrix (rev2 using WS2811B)

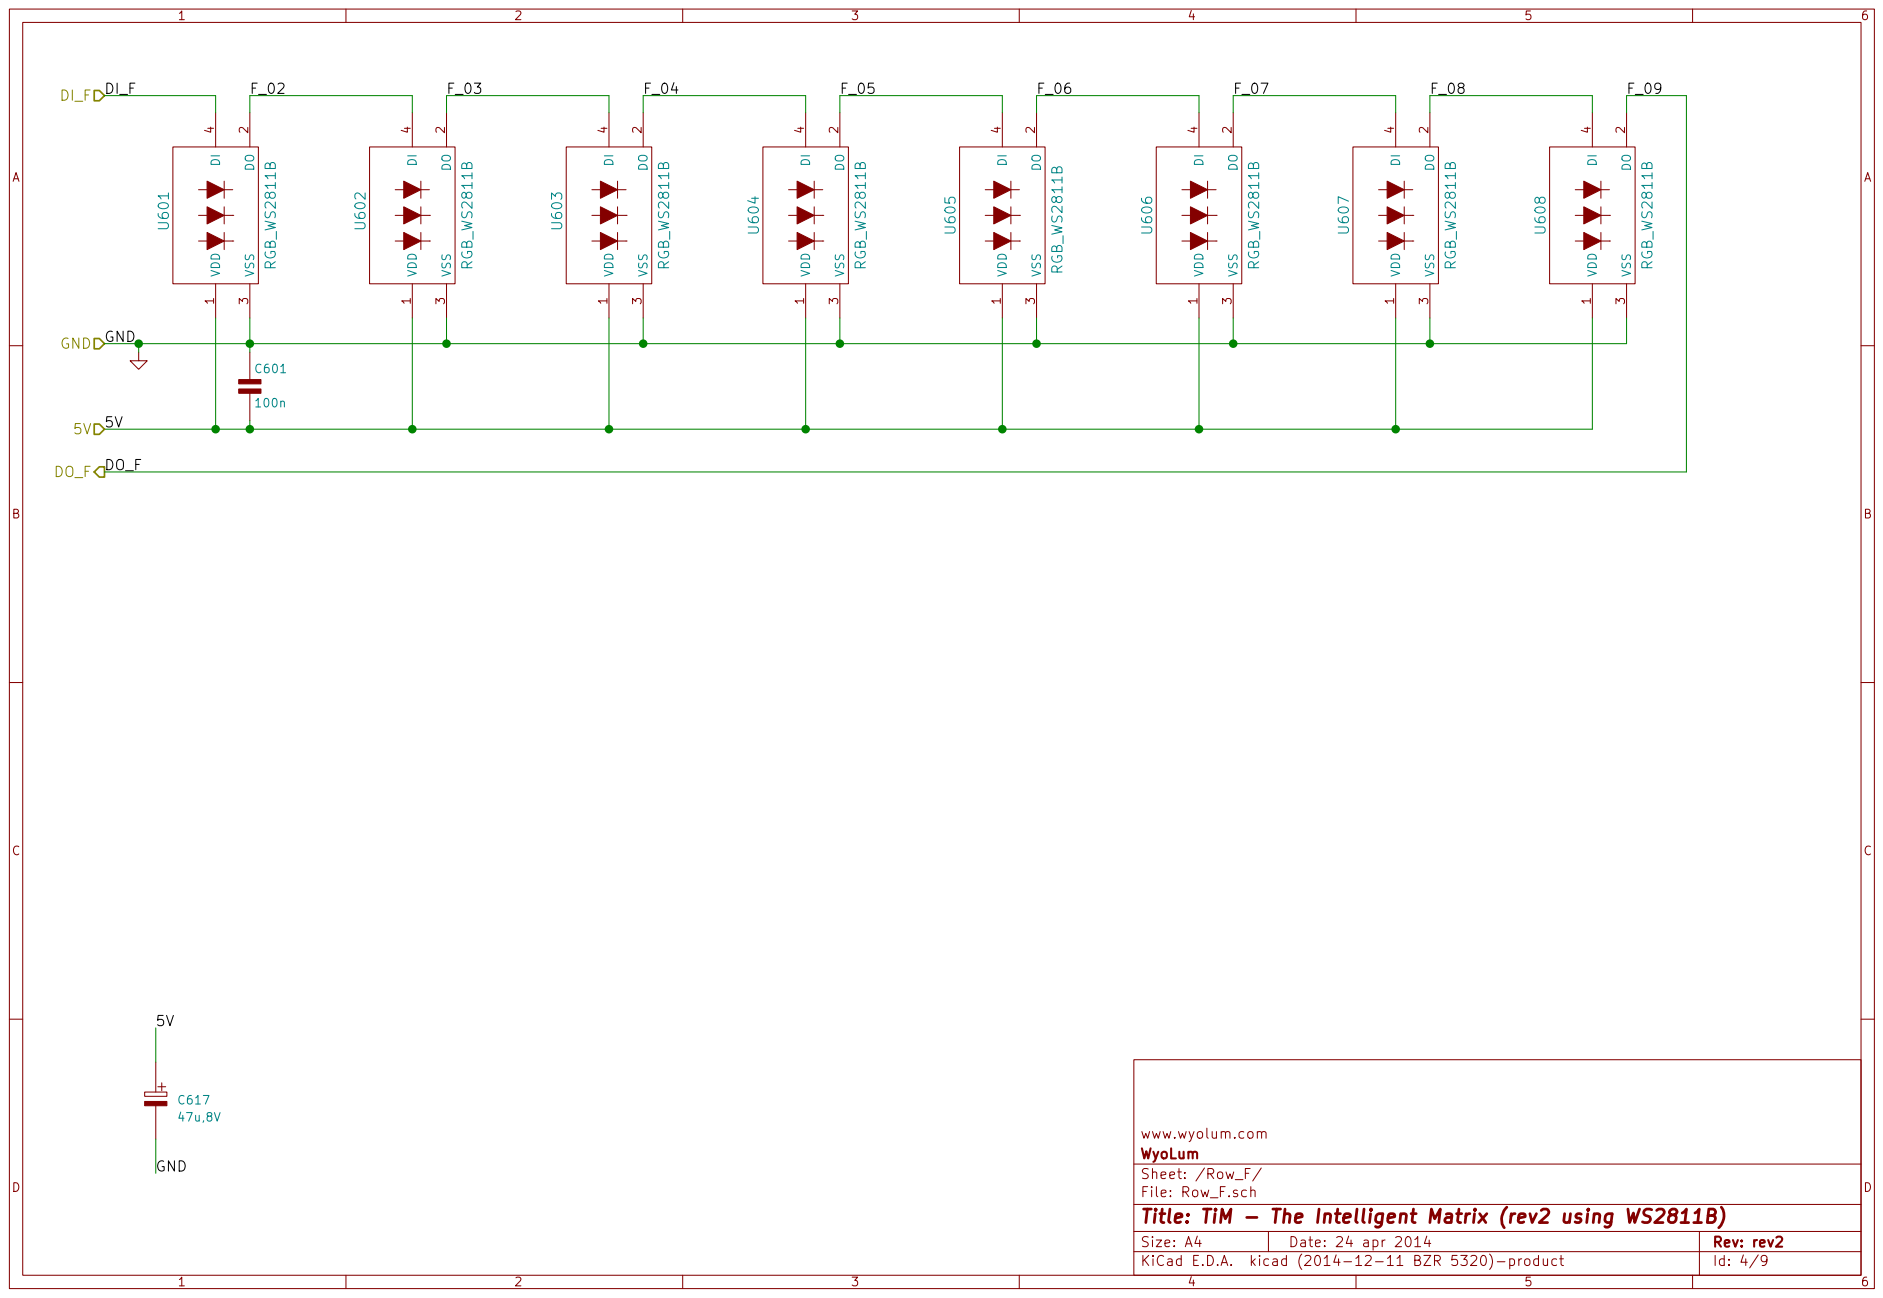
[picture p29: page 4]

www.wyolum.com
WyoLum
Sheet: /Row_F/
File: Row_F.sch
Id: 4/9 Title: TiM - The Intelligent Matrix (rev2 using WS2811B)

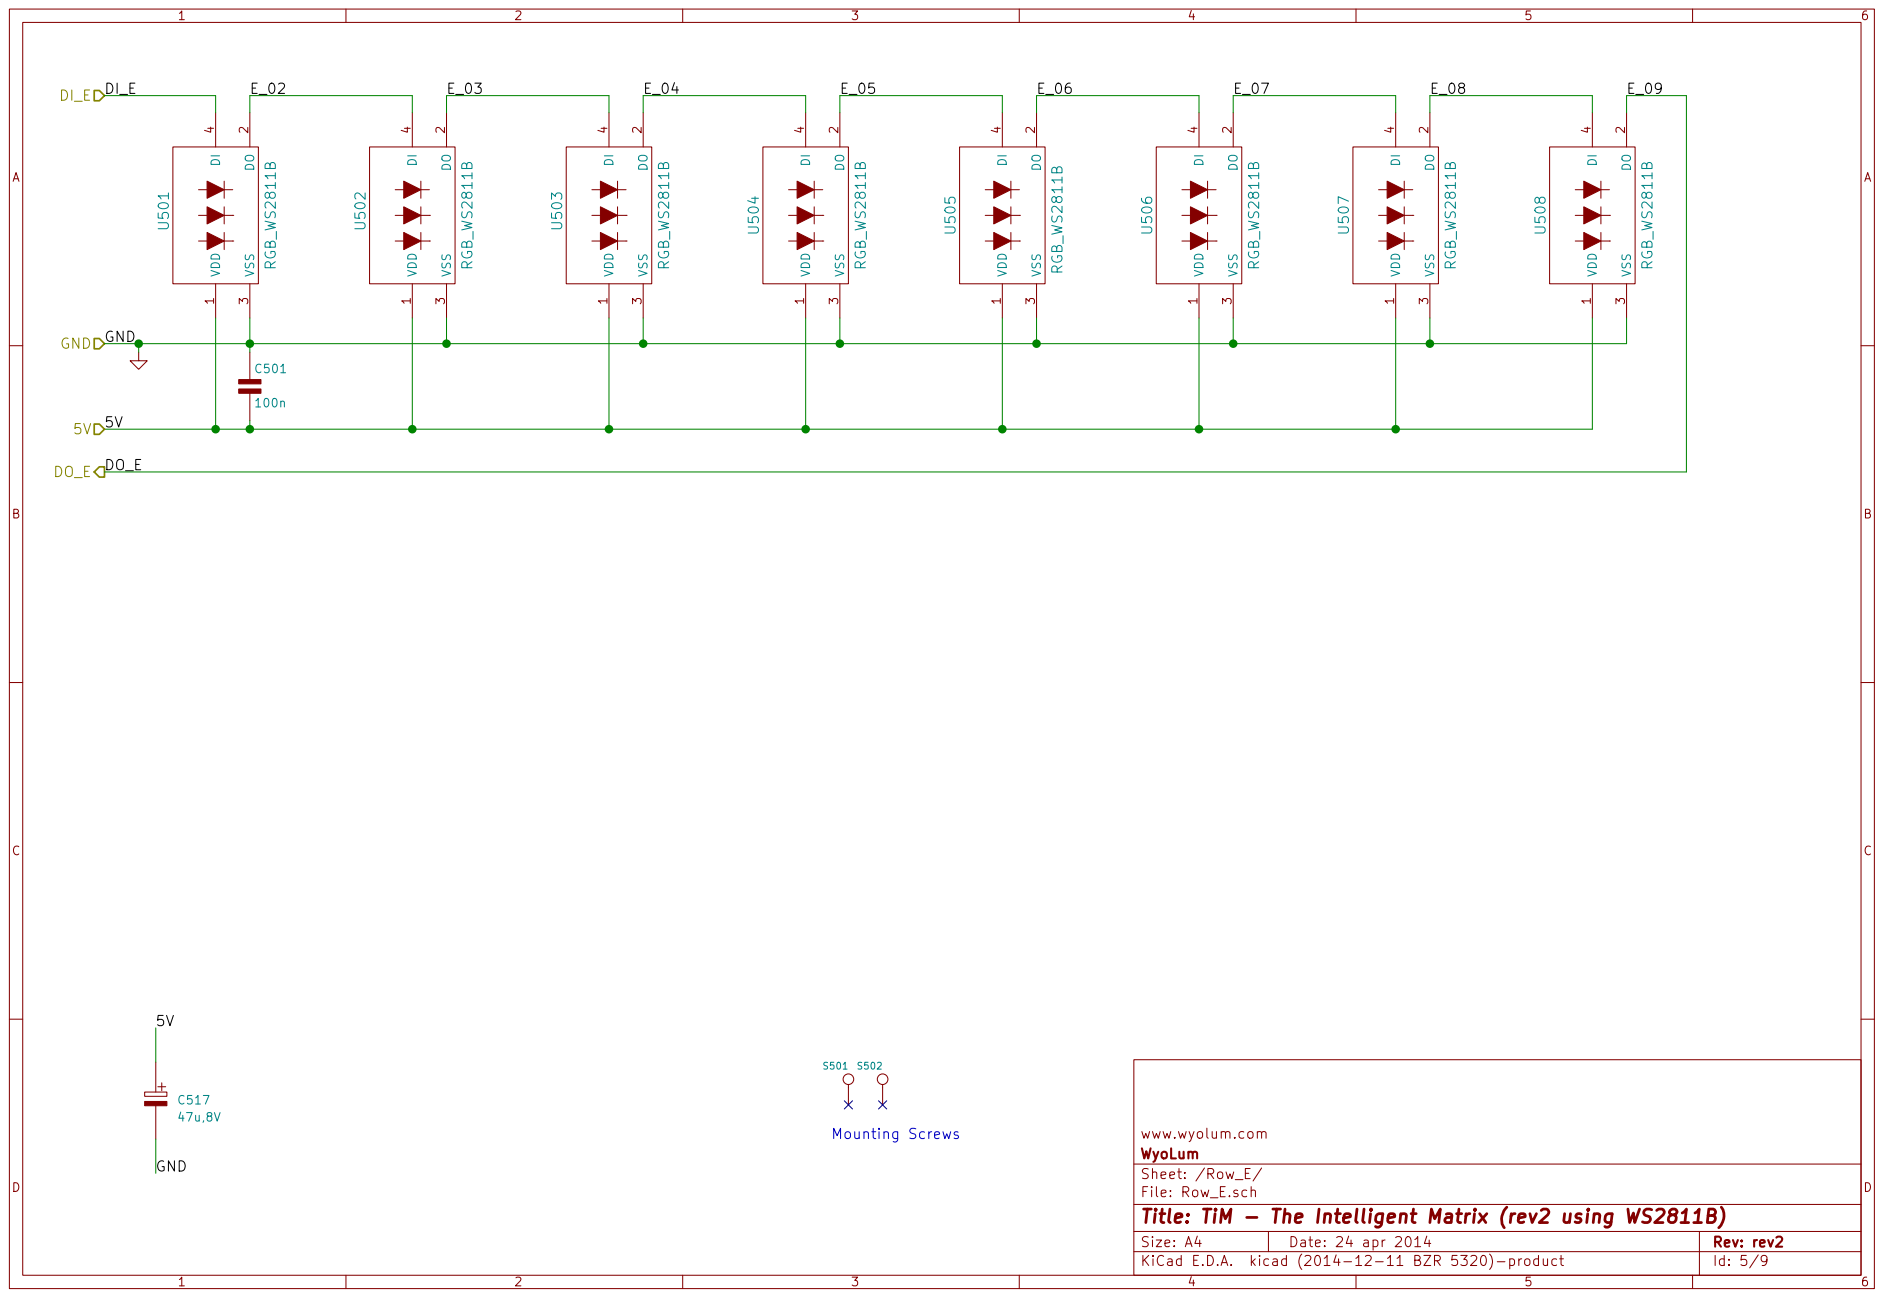
[picture p30: page 5]

www.wyolum.com
WyoLum
Sheet: /Row_E/
File: Row_E.sch
Id: 5/9 Title: TiM - The Intelligent Matrix (rev2 using WS2811B)

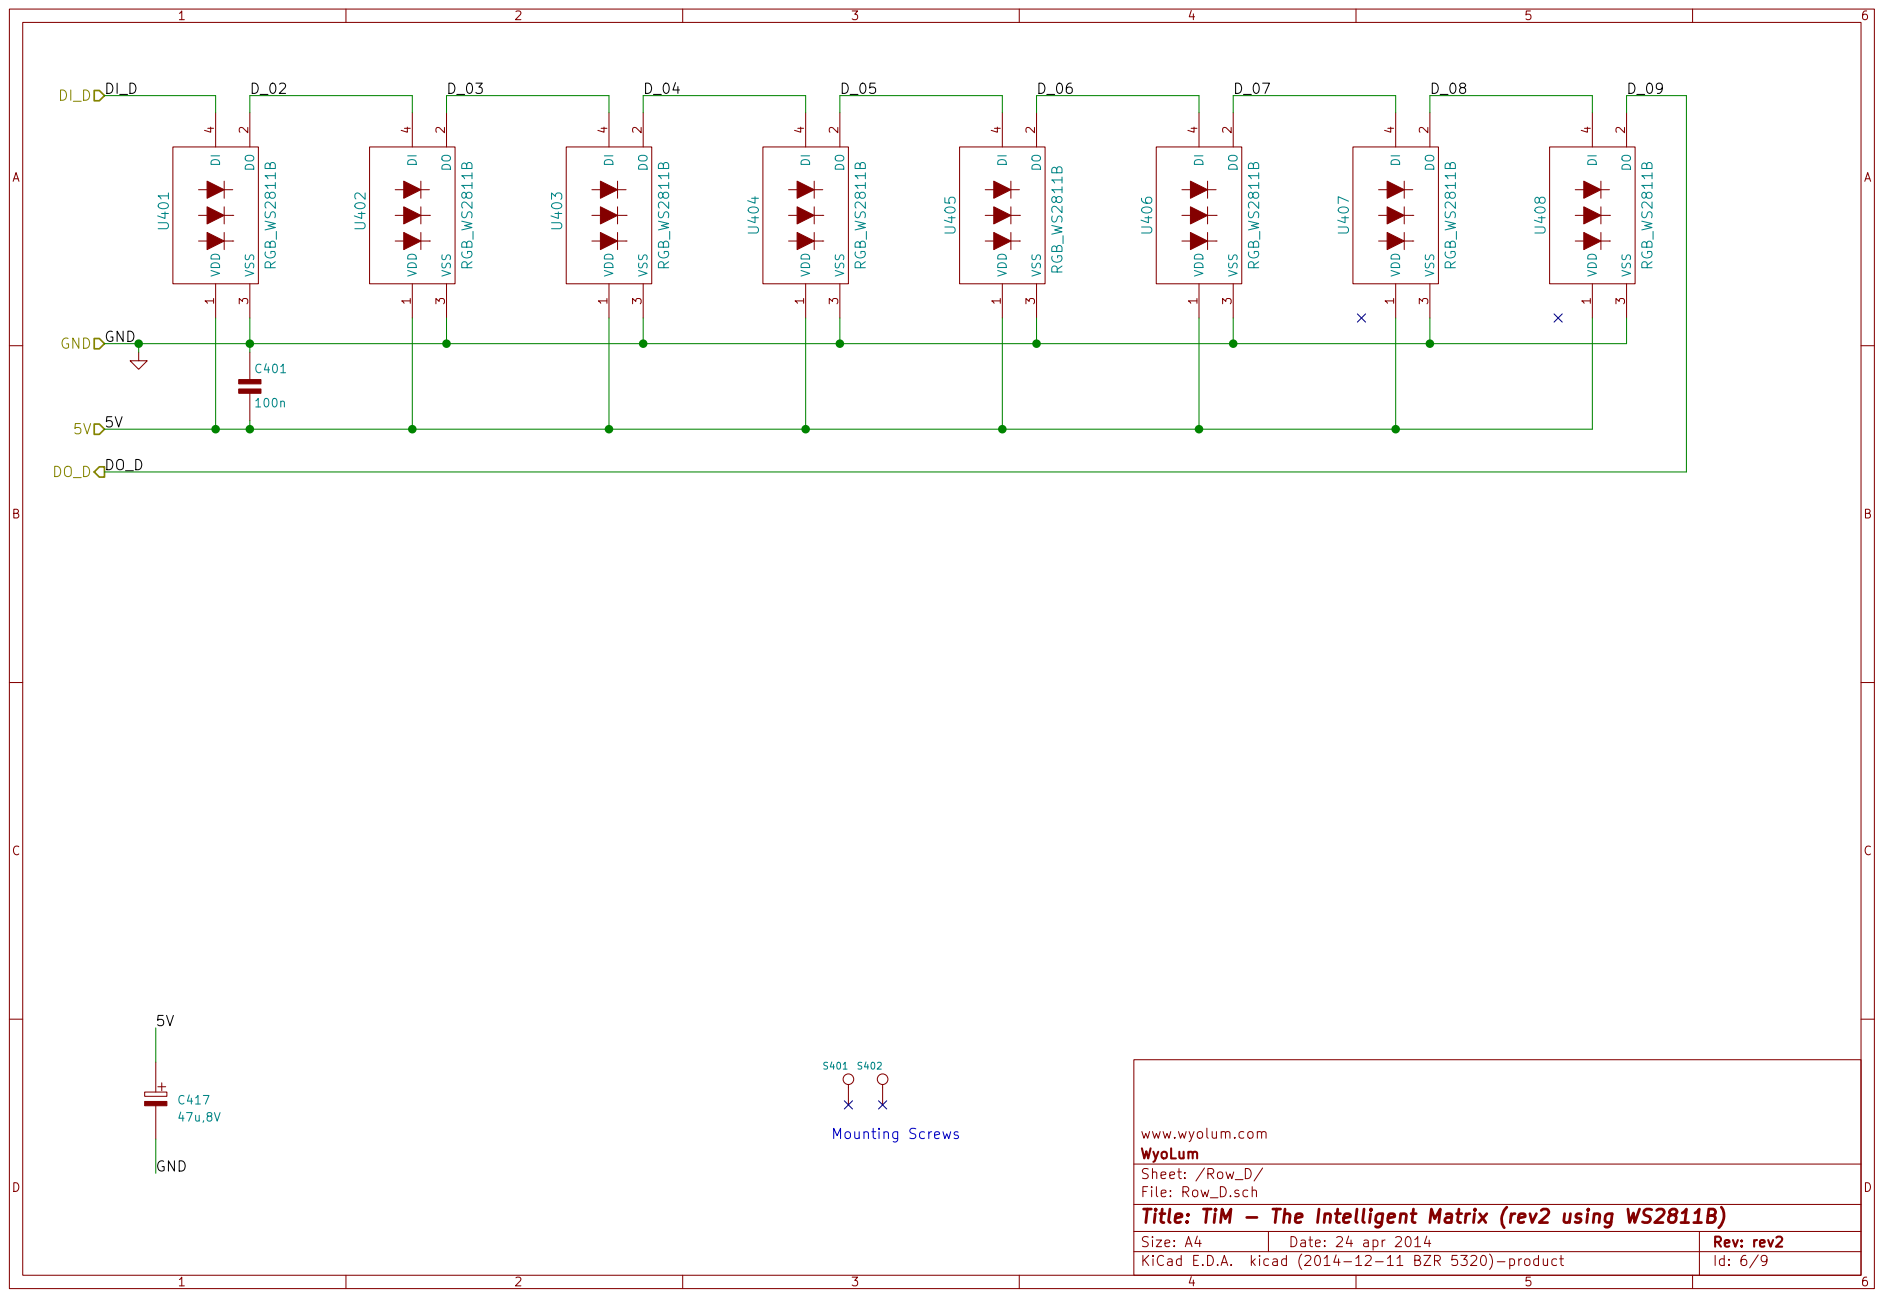
[picture p31: page 6]

www.wyolum.com
WyoLum
Sheet: /Row_D/
File: Row_D.sch
Id: 6/9 Title: TiM - The Intelligent Matrix (rev2 using WS2811B)

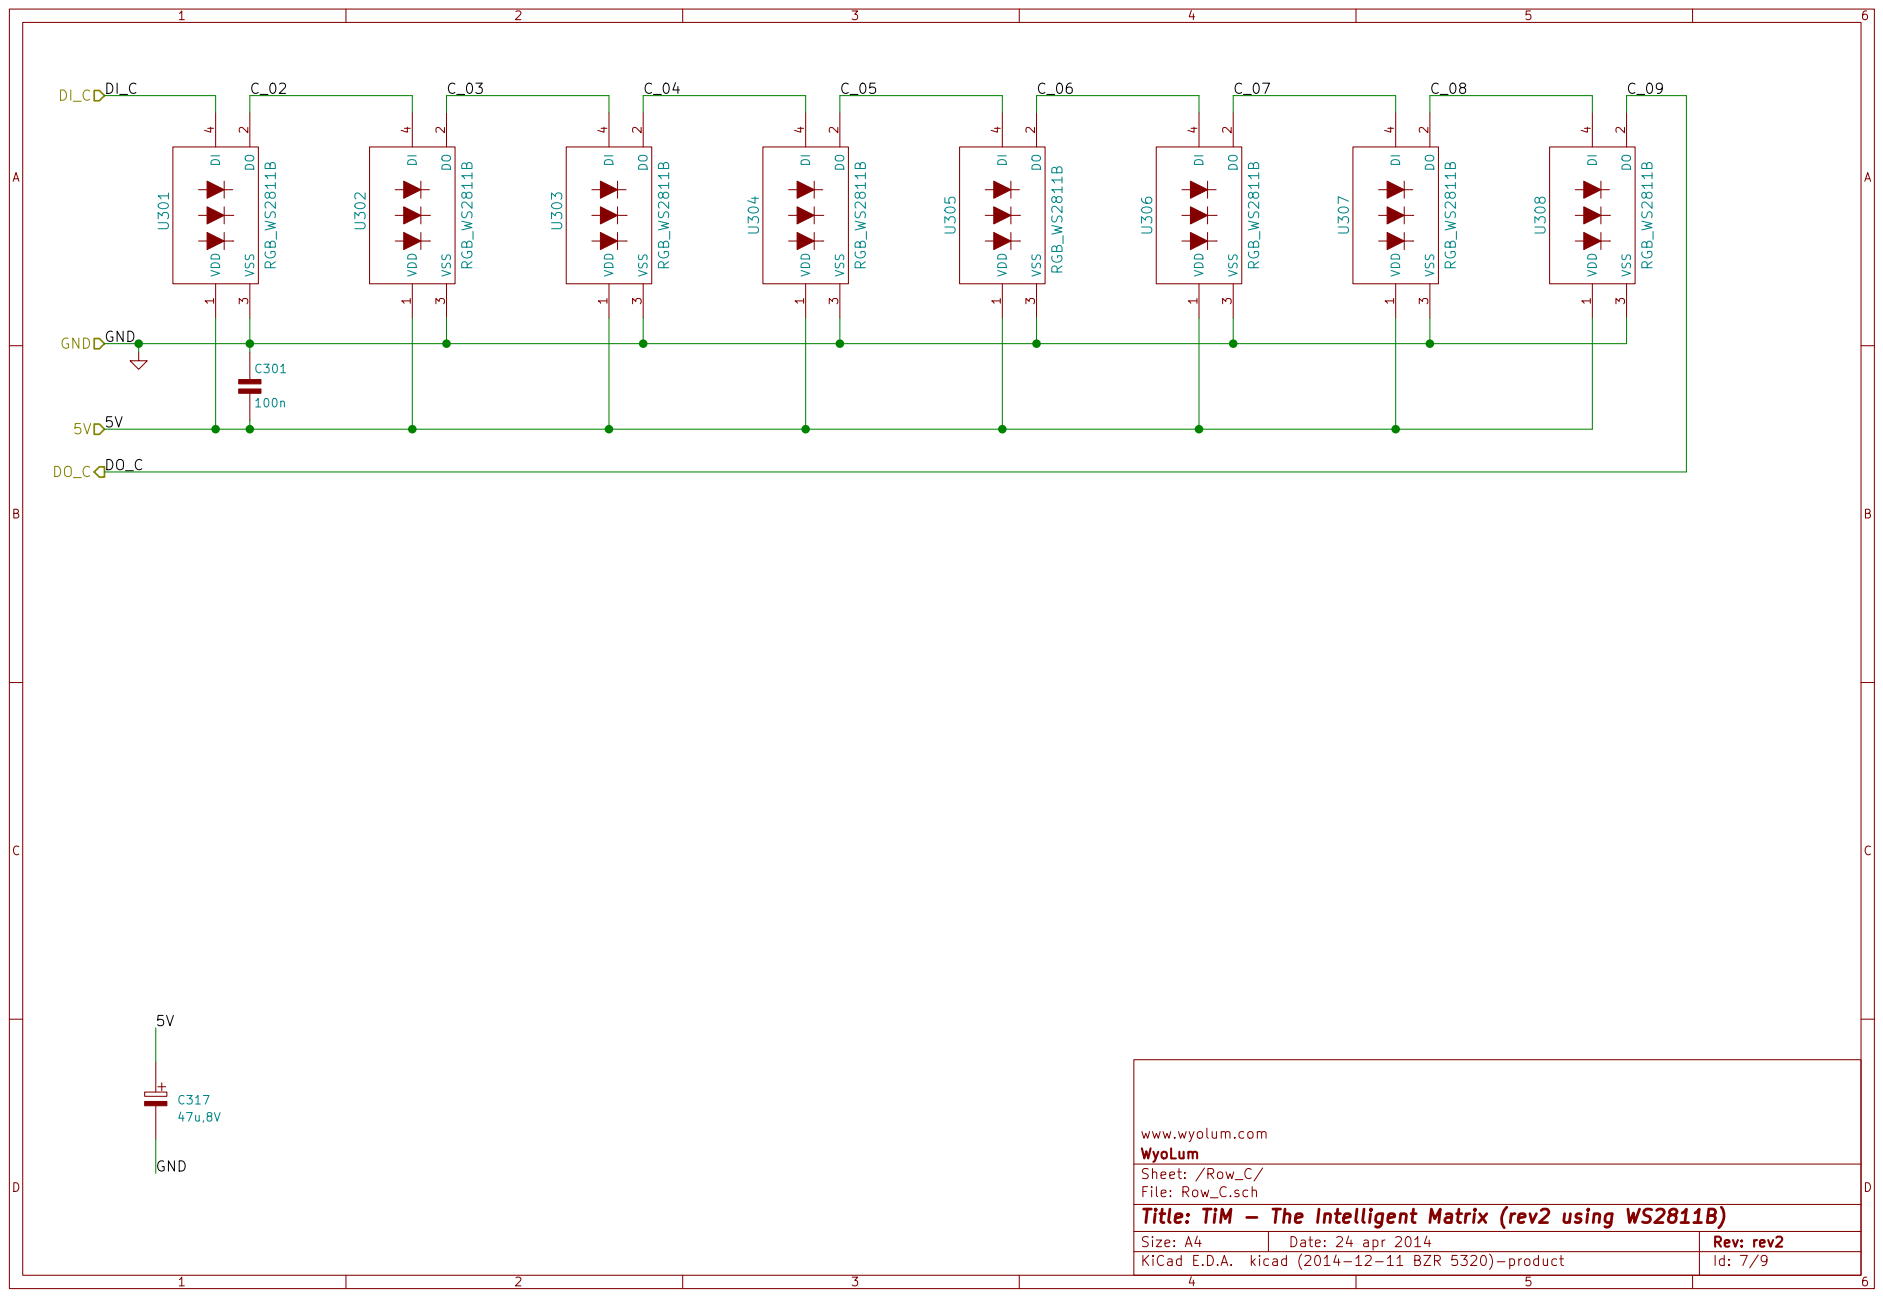
[picture p32: page 7]

www.wyolum.com
WyoLum
Sheet: /Row_C/
File: Row_C.sch
Id: 7/9 Title: TiM - The Intelligent Matrix (rev2 using WS2811B)

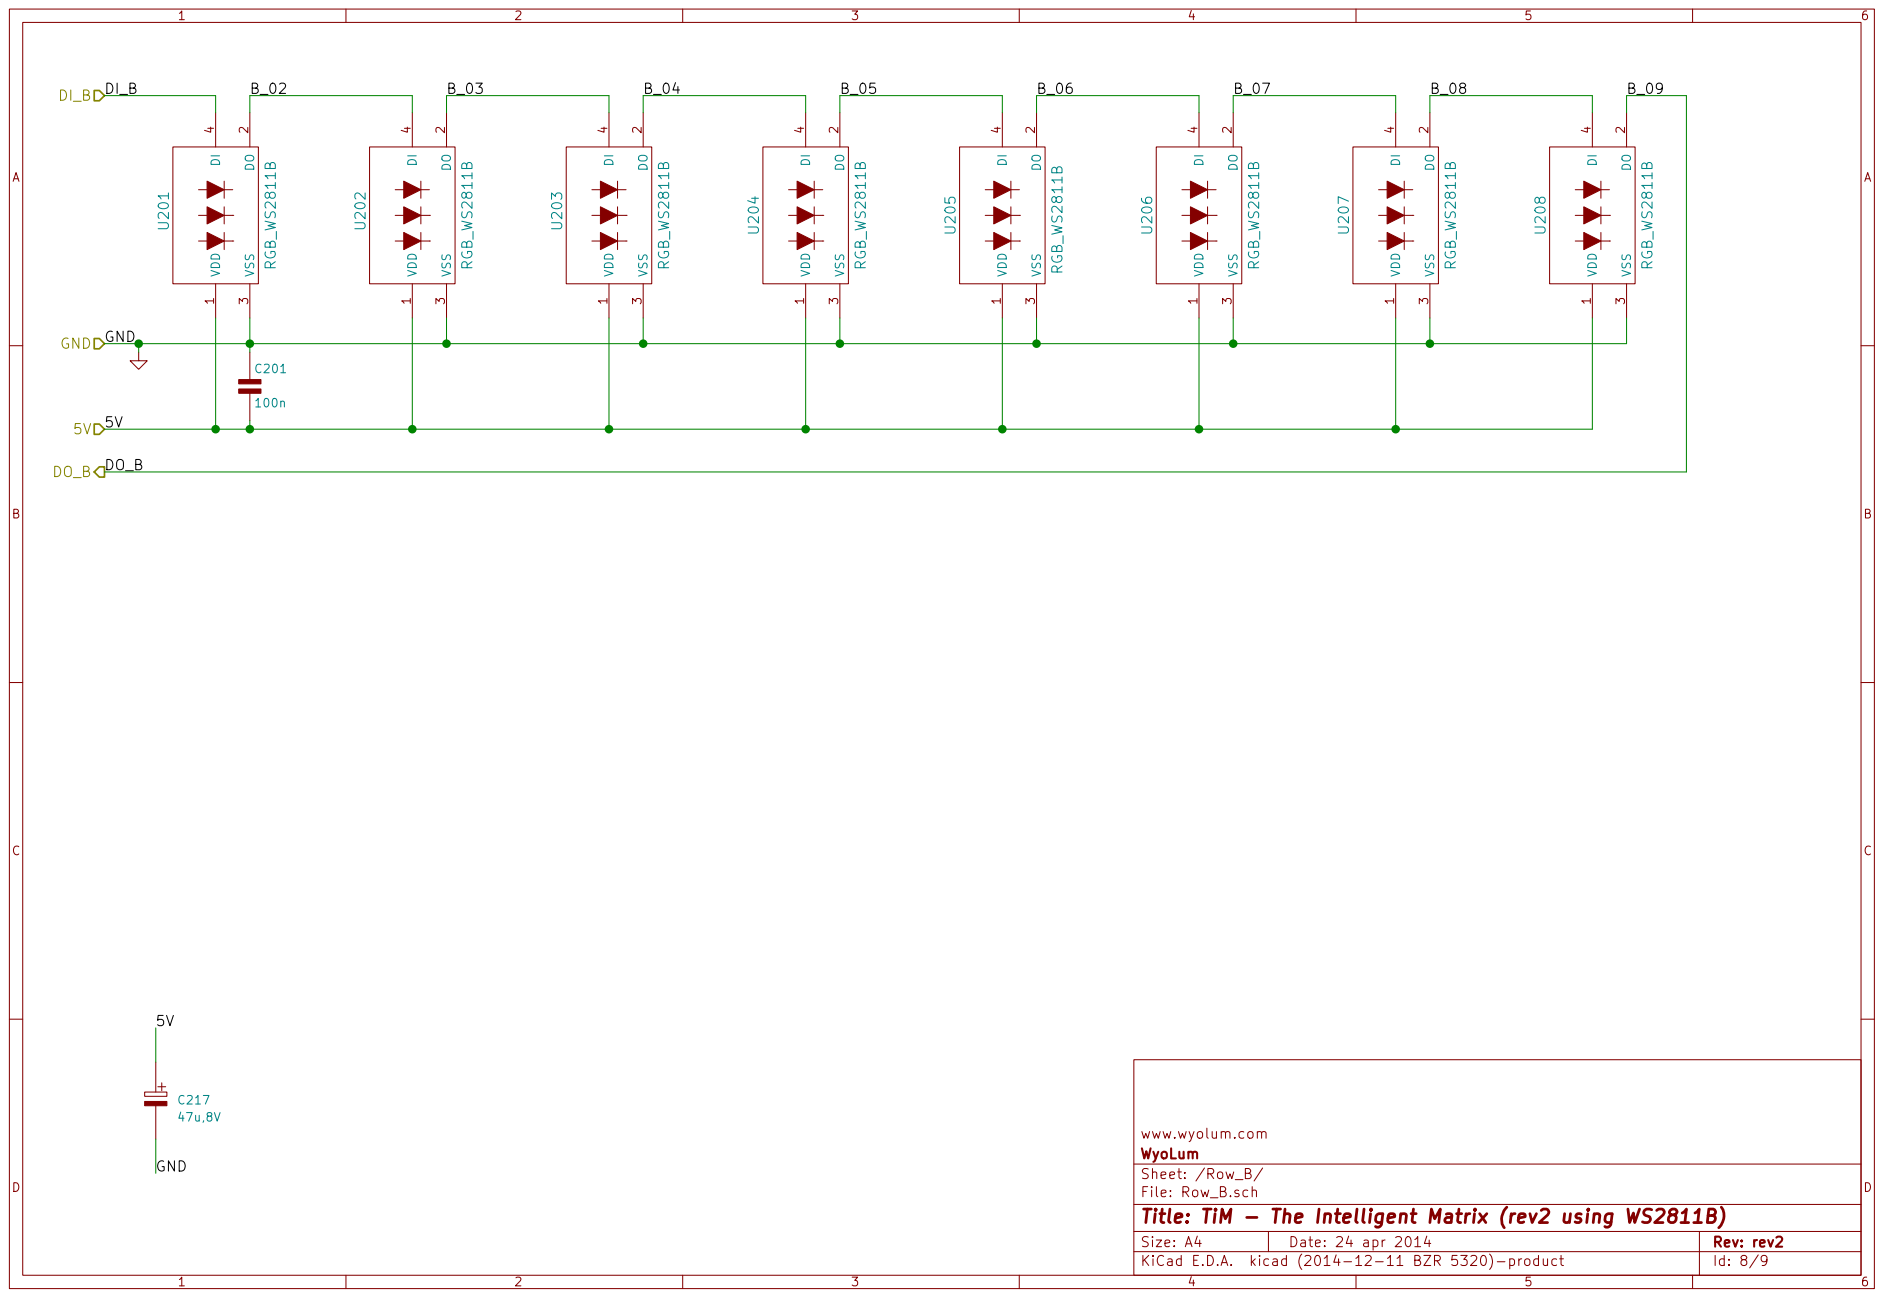
[picture p33: page 8]

www.wyolum.com
WyoLum
Sheet: /Row_B/
File: Row_B.sch
Id: 8/9 Title: TiM - The Intelligent Matrix (rev2 using WS2811B)

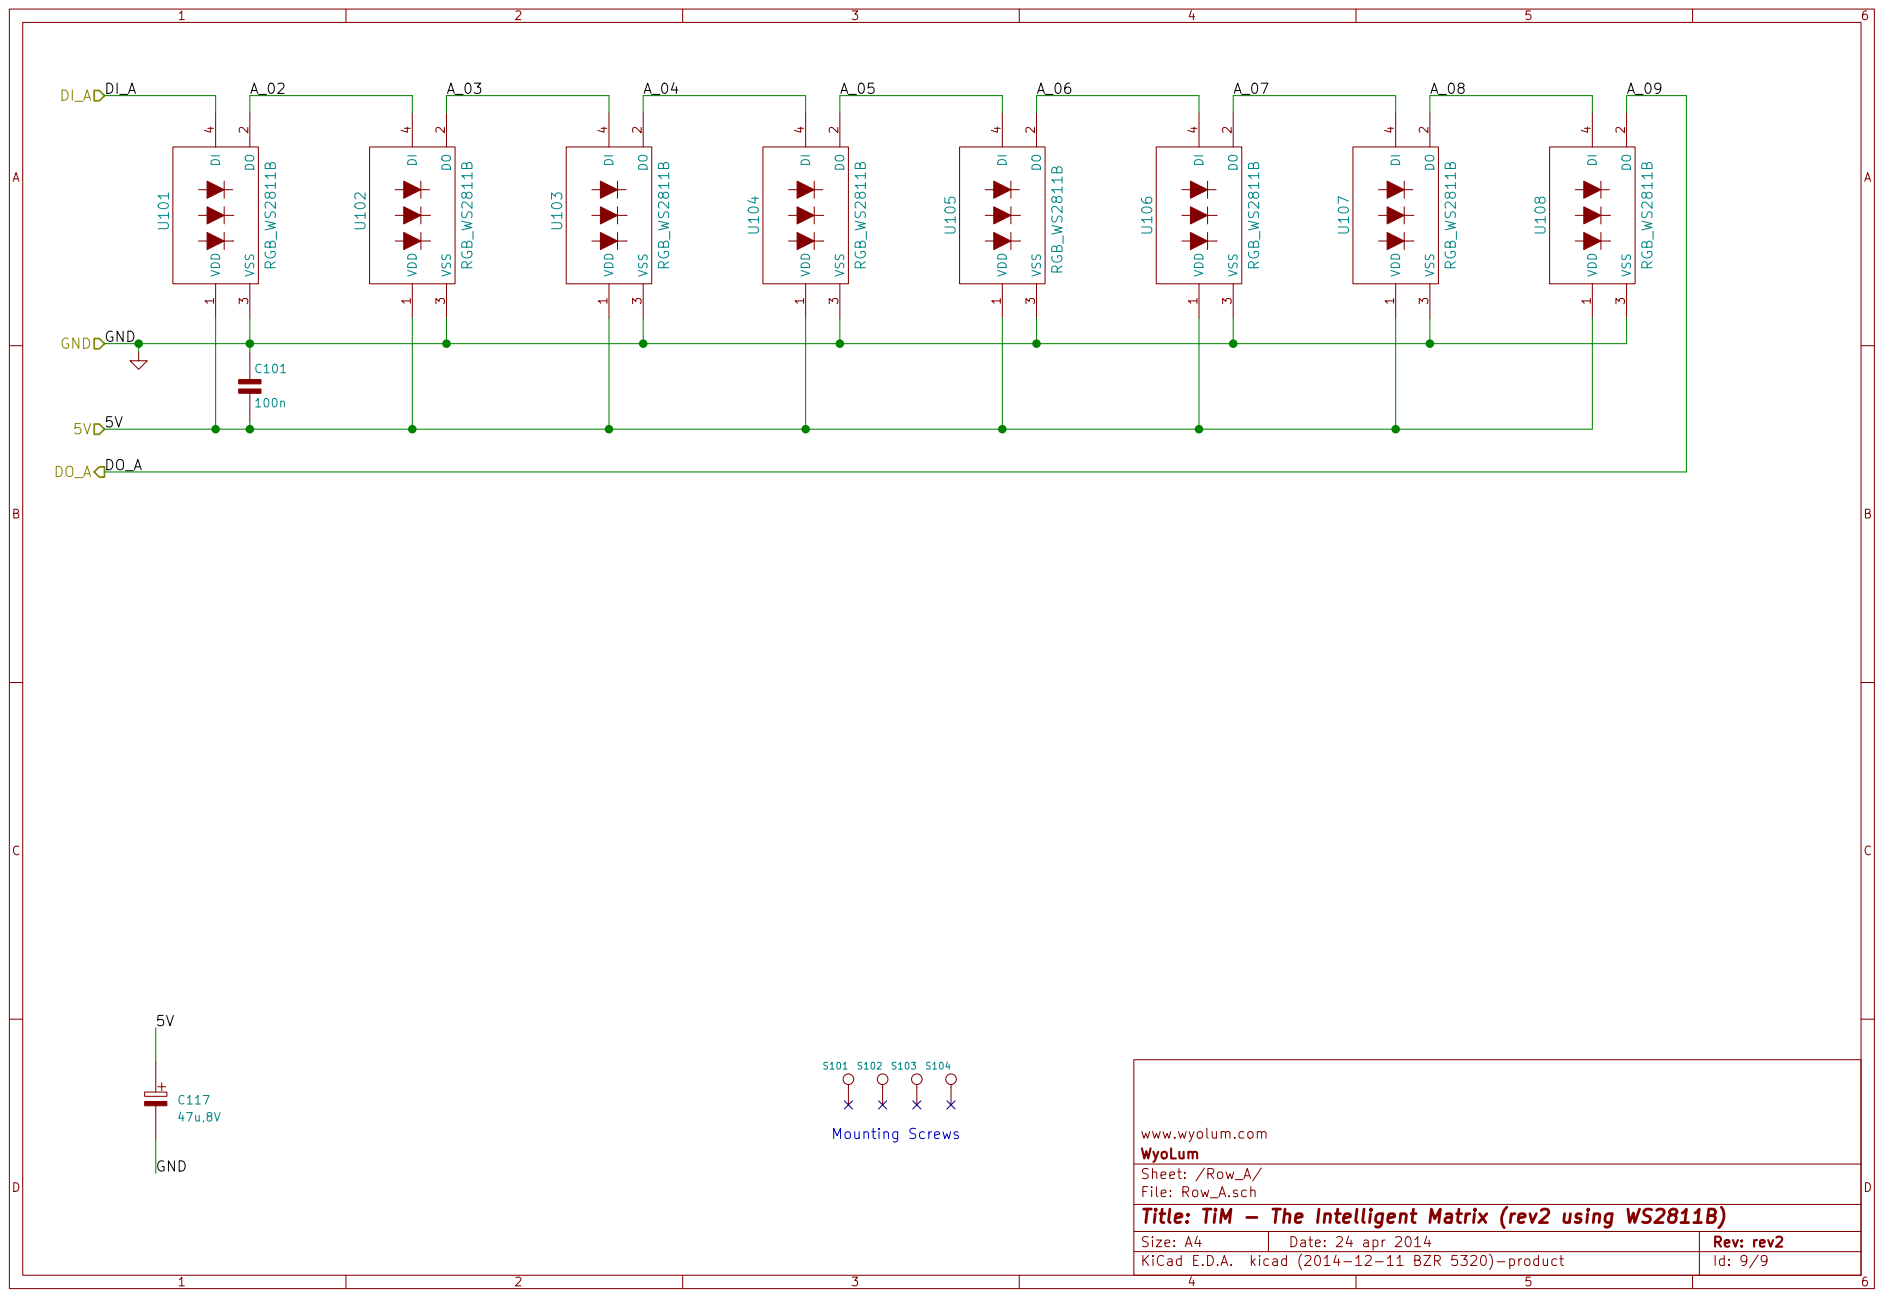
[picture p34: page 9]

www.wyolum.com
WyoLum
Sheet: /Row_A/
File: Row_A.sch
Id: 9/9 Title: TiM - The Intelligent Matrix (rev2 using WS2811B)
