wyolum/TinyTiM/KiCad/rev2/TinyTiM-PCB.pdf

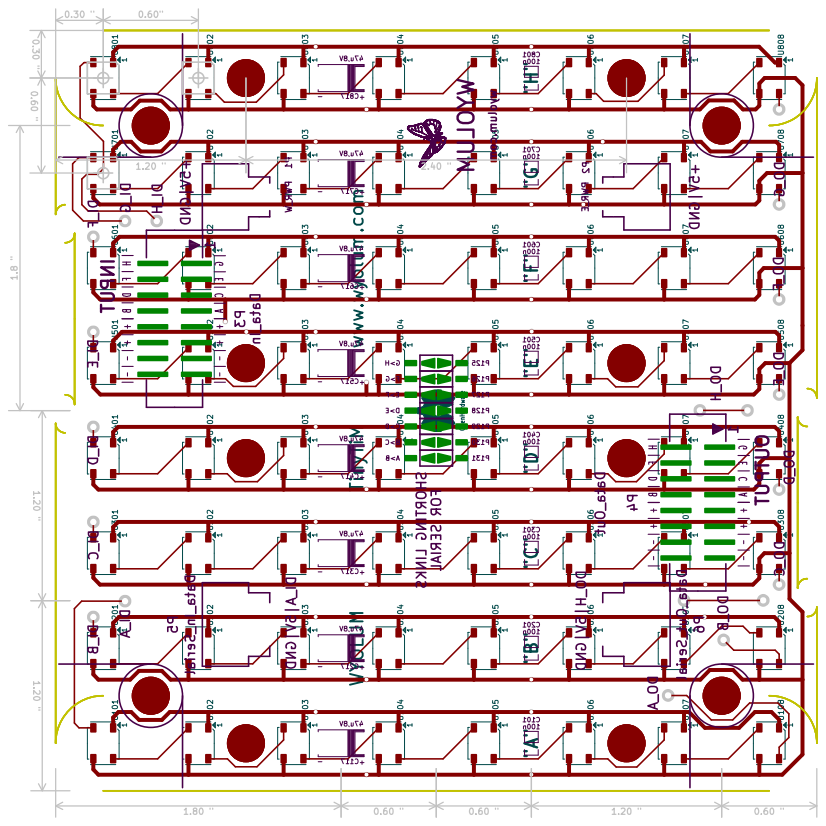
[picture p35: page 1]
