wyolum/TinyTiM/KiCad/rev2/TinyTiM-PCB_Layers.pdf

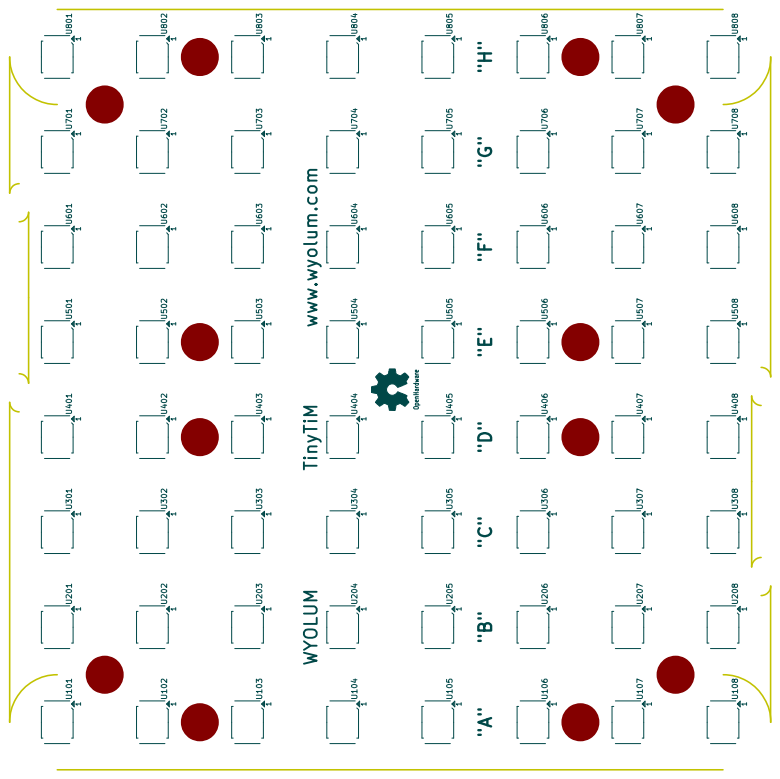
[picture p36: page 1]

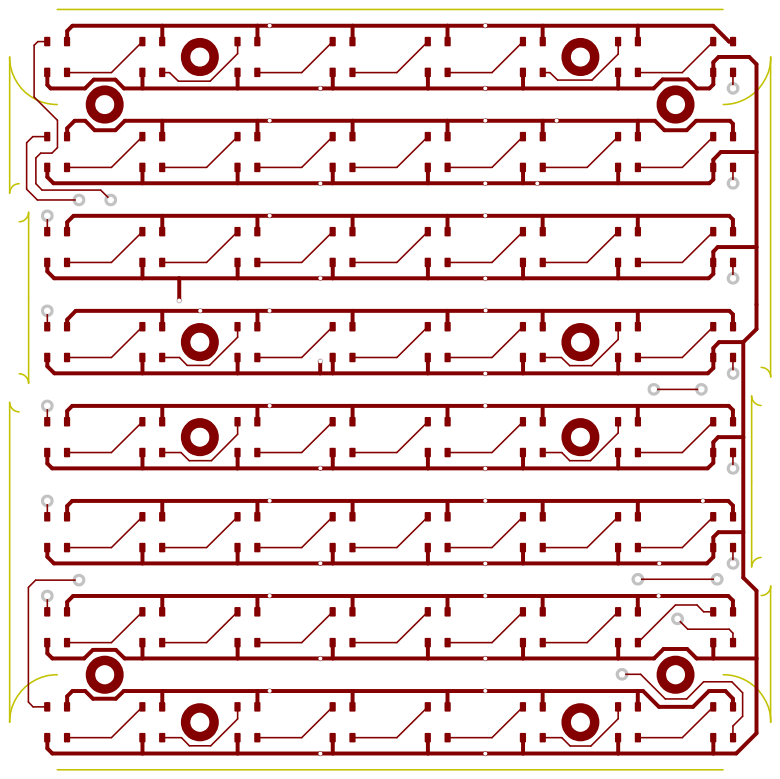
[picture p37: page 2]

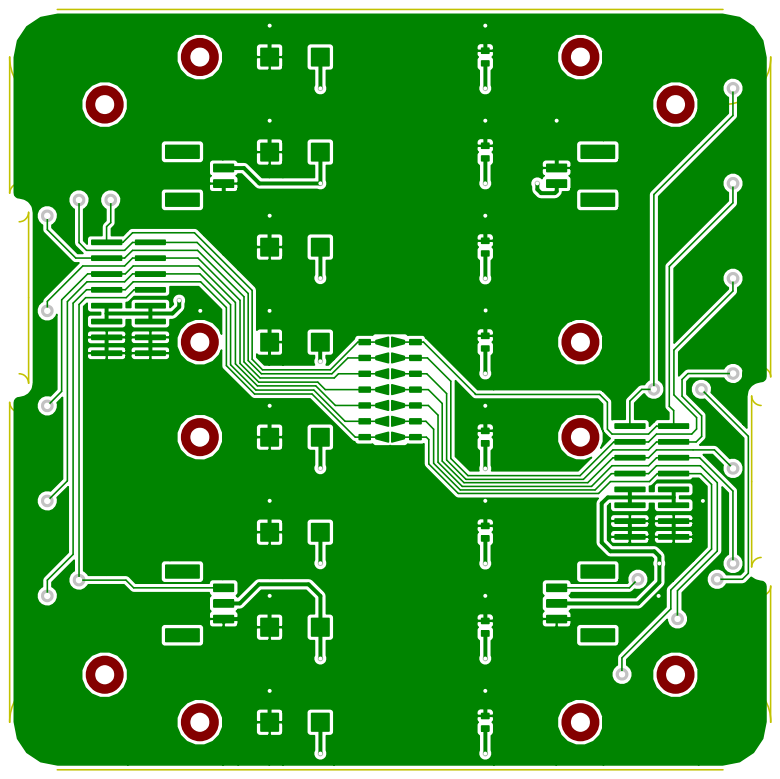
[picture p38: page 3]

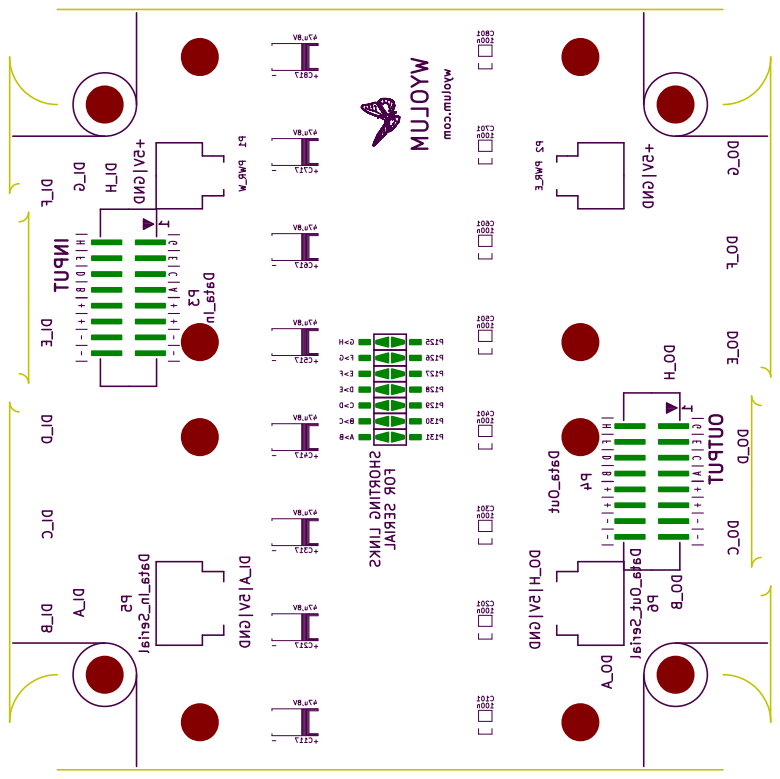
[picture p39: page 4]

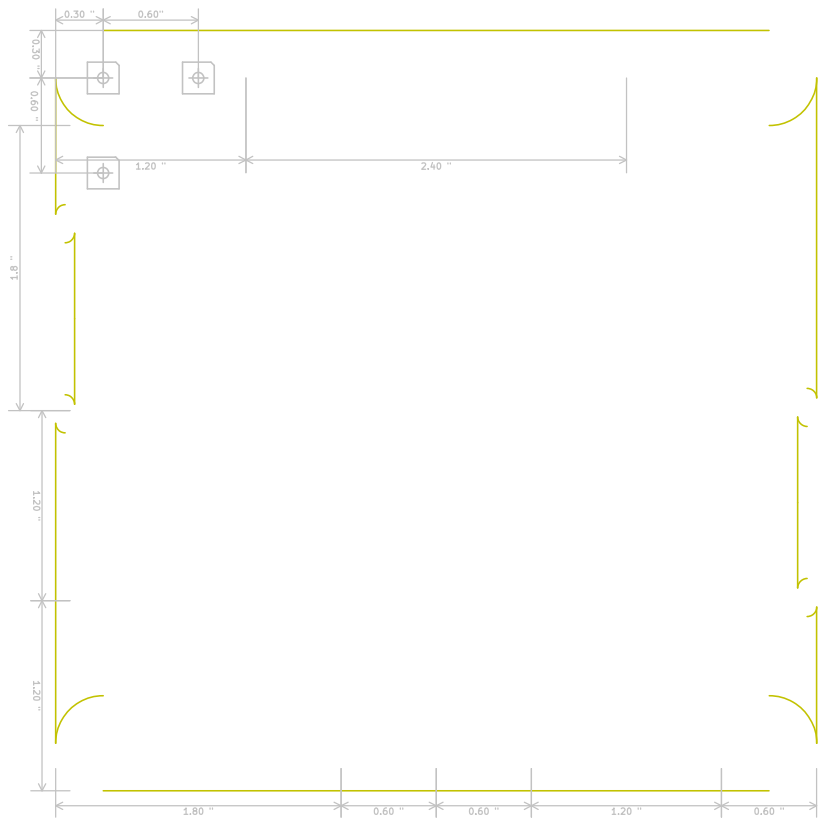
[picture p40: page 5]
