wyolum/TinyTiM/KiCad/rev1/TinyTiM-PCB.pdf

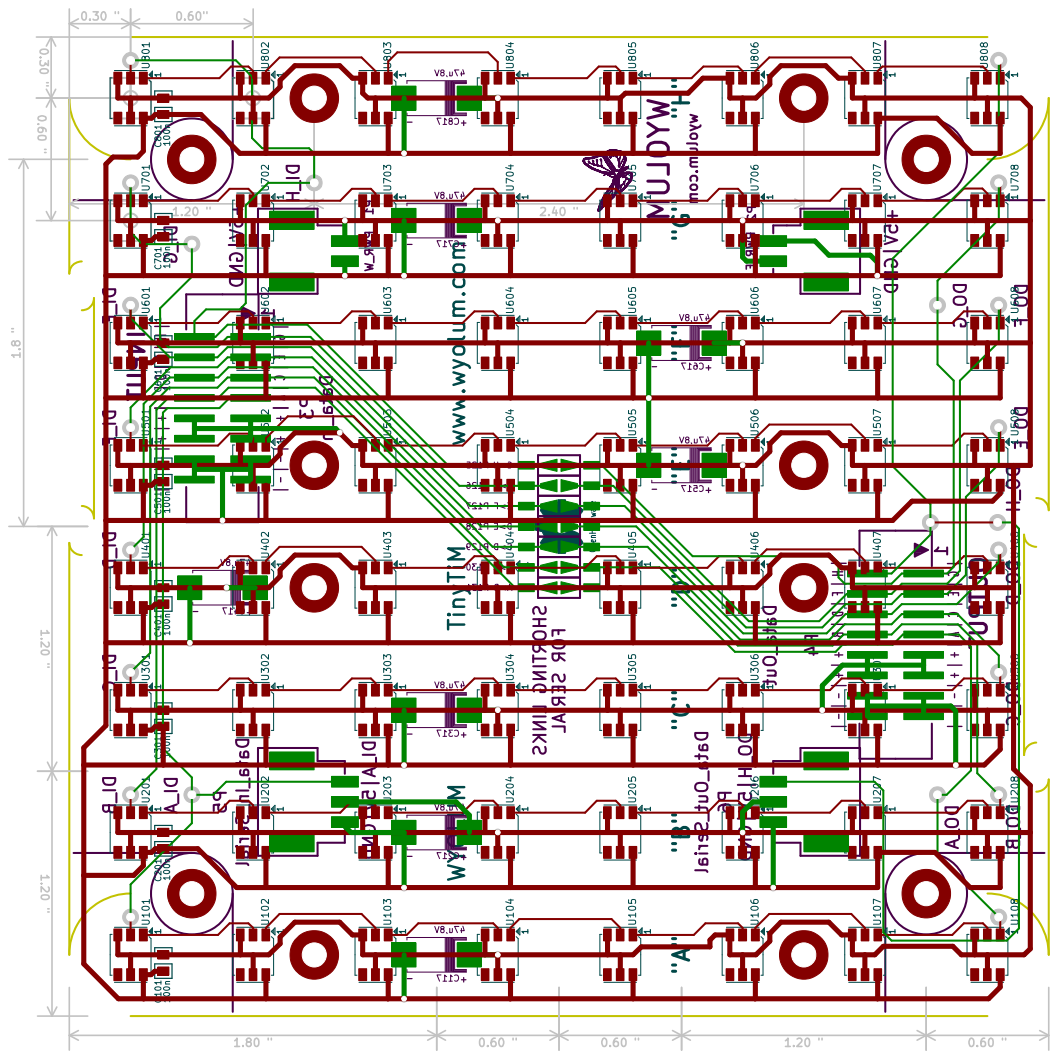
[picture p41: page 1]
