wyolum/TinyTiM/KiCad/rev2/TinyTiM_Gerber/TinyTiM-B_Cu.pdf

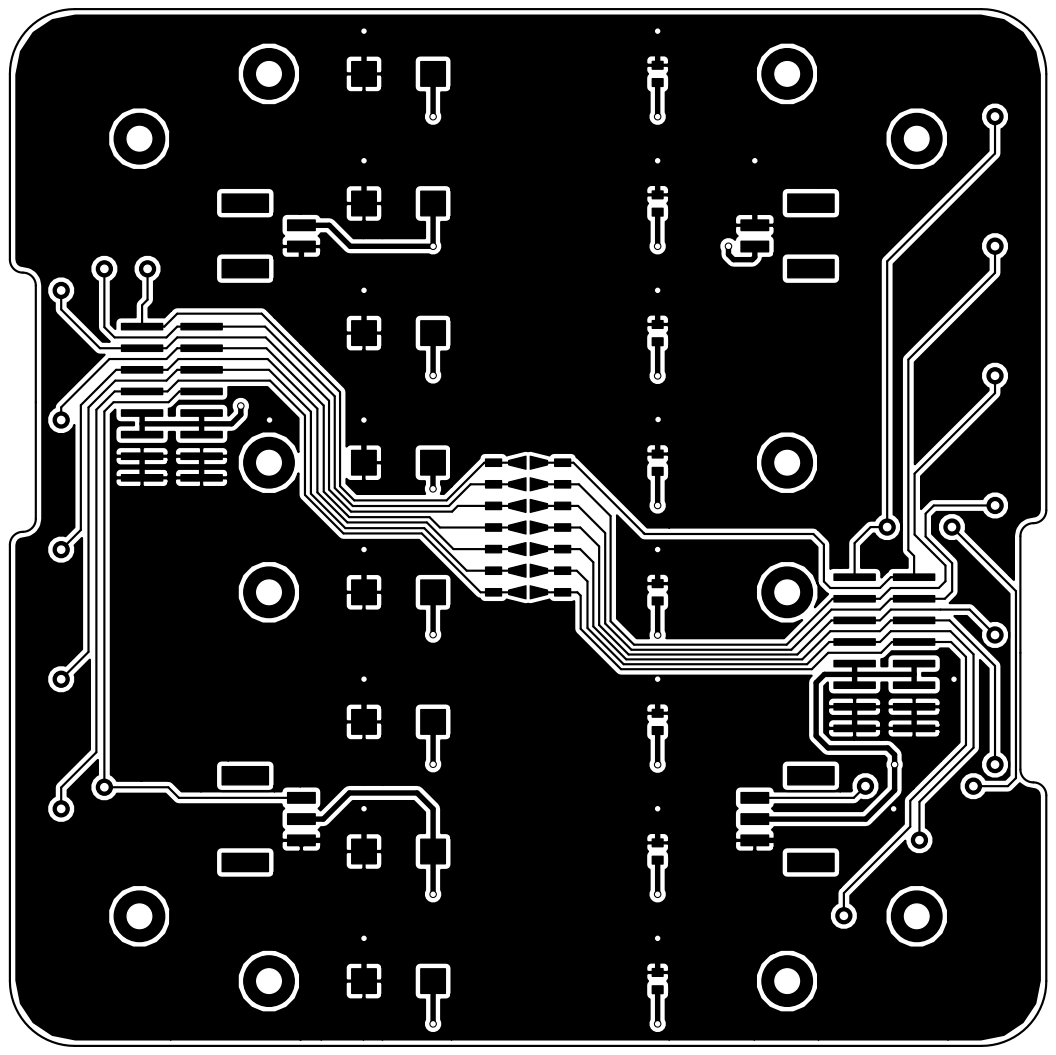
[picture p56: page 1]
