wyolum/TinyTiM/KiCad/rev2/TinyTiM_Gerber/TinyTiM-B_SilkS.pdf

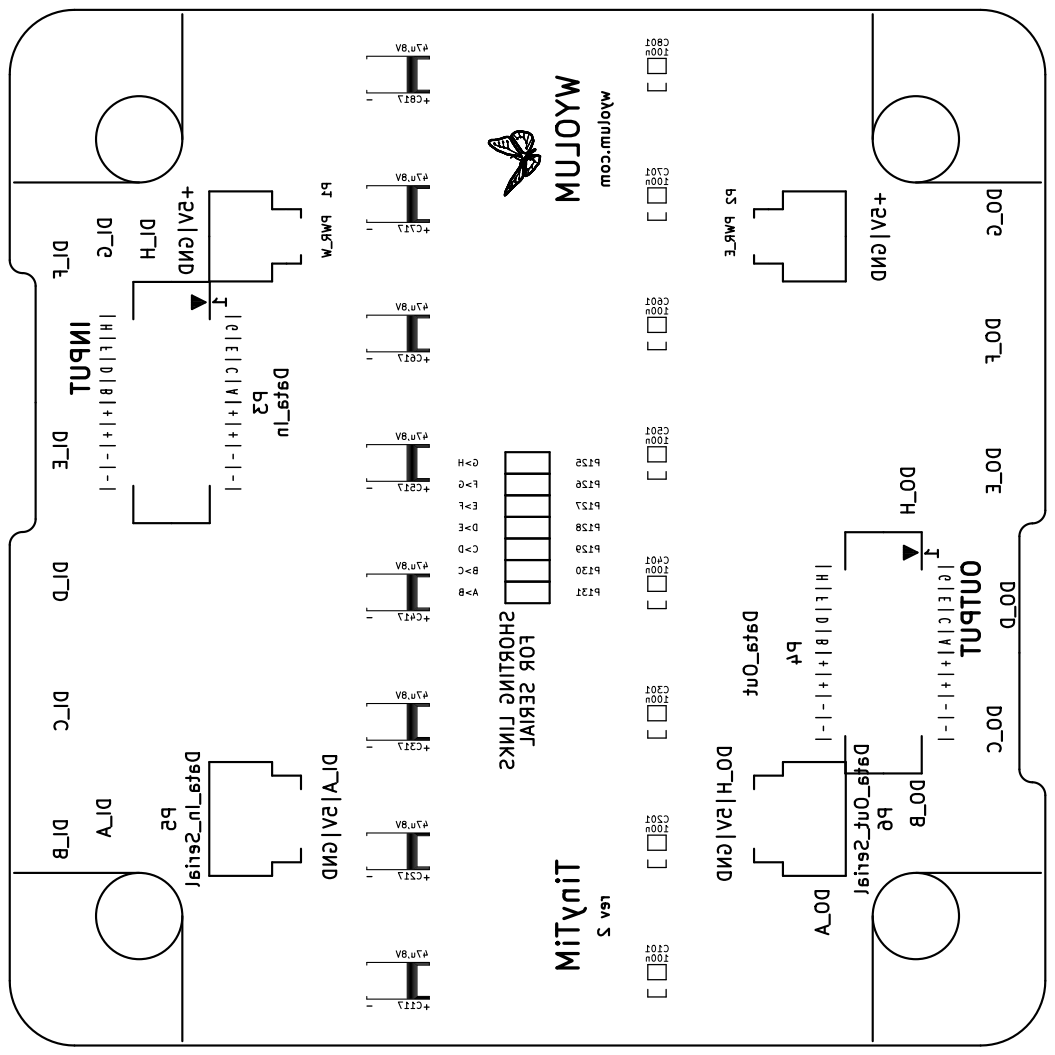
[picture p57: page 1]
