wyolum/TinyTiM/KiCad/rev2/TinyTiM_Gerber/TinyTiM-Dwgs_User.pdf

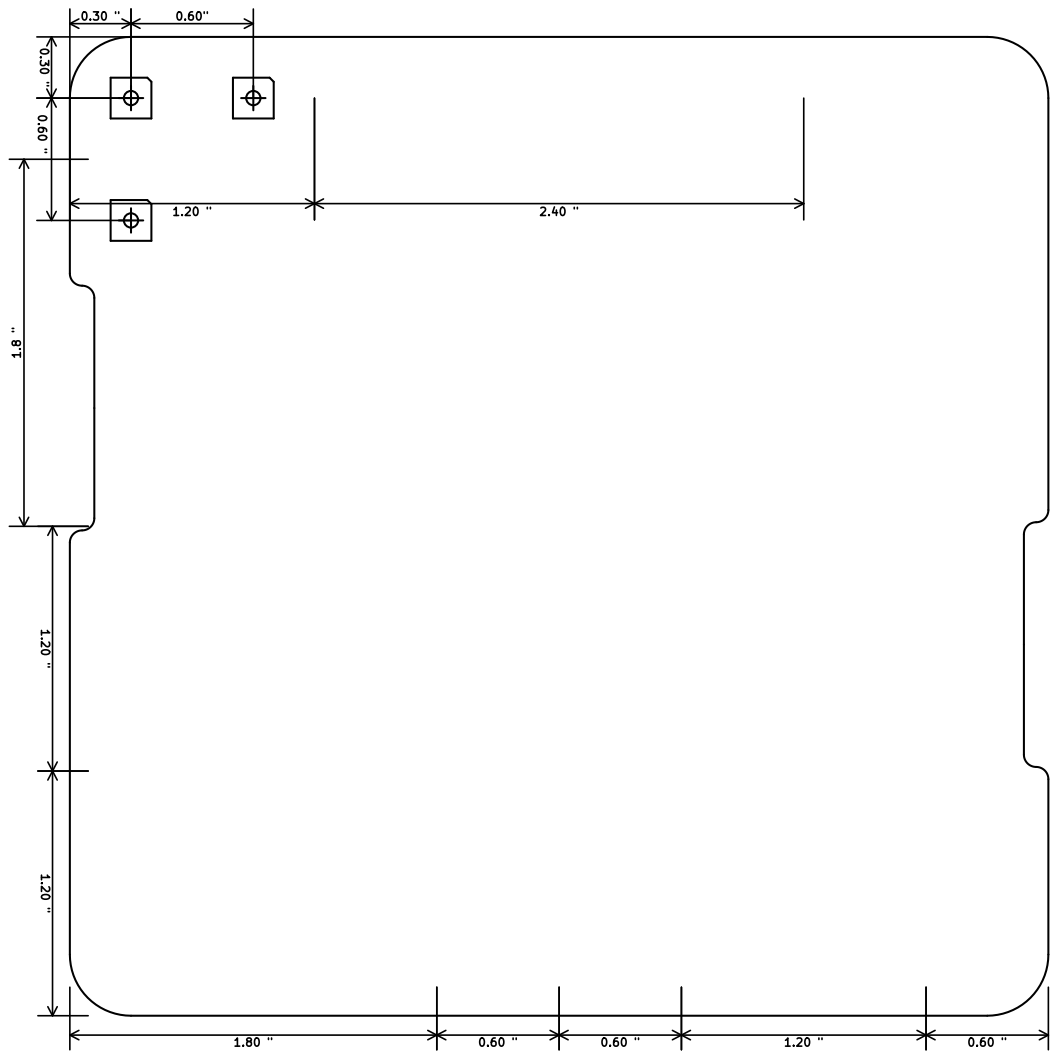
[picture p58: page 1]
