wyolum/TinyTiM/KiCad/rev2/TinyTiM_Gerber/TinyTiM-F_Cu.pdf

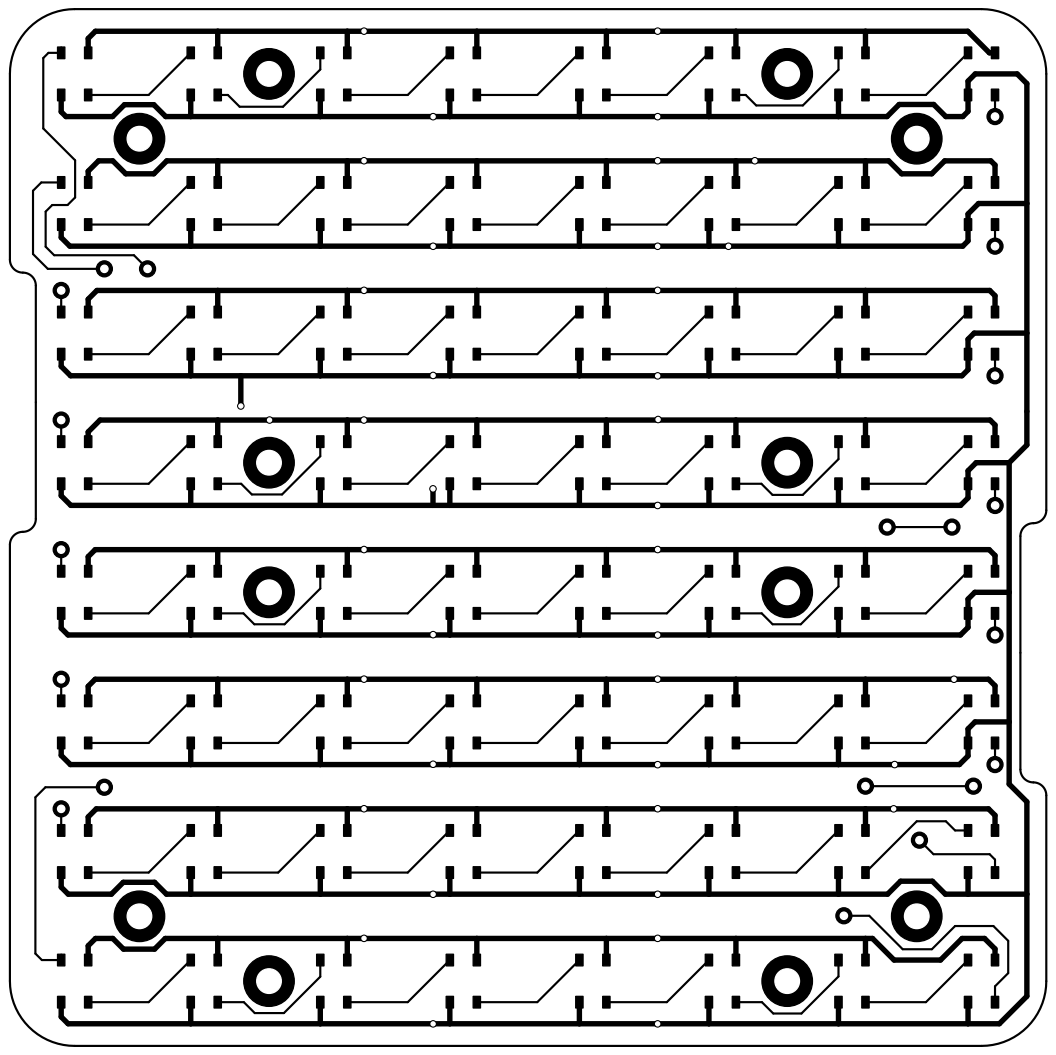
[picture p59: page 1]
