wyolum/TinyTiM/KiCad/rev2/TinyTiM_Gerber/TinyTiM-F_SilkS.pdf

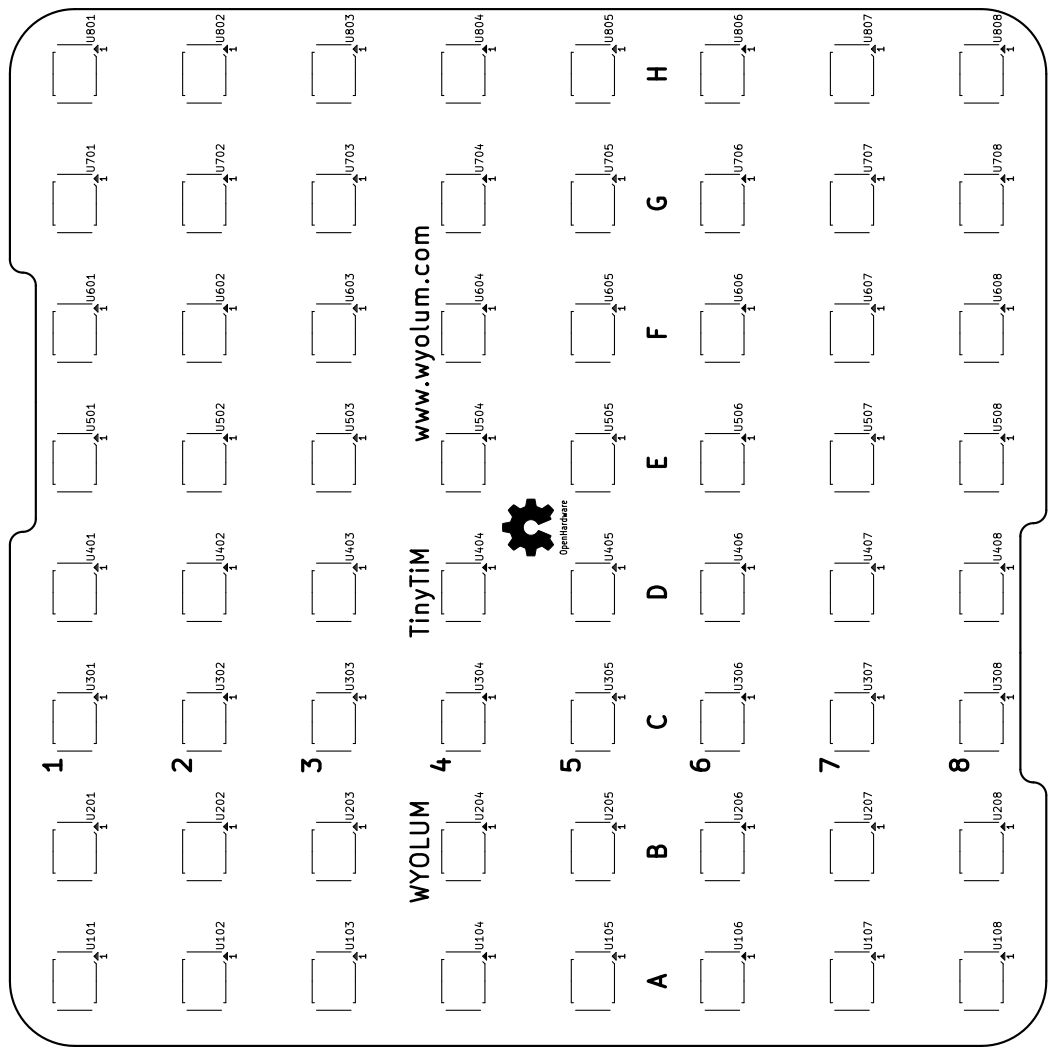
[picture p60: page 1]
