wyolum/TinyTiM/(commit log)

2014-04-19 initial push for TinyTiM KiCad project files
    [Row_A.sch, Row_B.sch, Row_C.sch, Row_D.sch, Row_E.sch, Row_F.sch, Row_G.sch, Row_H.sch]
2014-04-21 TinyTiM KiCad work in progress
    [TinyTiM.kicad_pcb]
2014-04-23 KiCad work in progress
2014-04-25 board layout done. BoM ready
    [TinyTIM_BoM_pcb.csv, TinyTIM_BoM_sch.csv, TinyTIM_BoM_seeed.xls, TinyTiM.kicad_pcb, TinyTiM_BoM.ods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]
2014-04-25 ready for prototyping. Gerbers ready
    [TinyTiM.kicad_pcb]
2014-04-25 minor corrections in silk legend
    [TinyTiM.kicad_pcb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]
2014-04-26 minor mods to silk legend. Final, ready for prototyping
    [Male_Header_2x8.stl, TinyTiM.kicad_pcb, TinyTiM.sch, User Library-20-pin SMT header.stl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]
2014-04-26 Final. ready for prototyping. Gerbers added.
    [TinyTiM.kicad_pcb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]
2014-04-28 TinyTiM Gerbers added.
2014-05-20 TinyTiM prototype moved to rev1 folder. Added rev2 folder for 4pin verison of WS2812B
    [Male_Header_2x8.stl, Row_A.sch, Row_B.sch, Row_C.sch, Row_D.sch, Row_E.sch, Row_F.sch, Row_G.sch]
2014-05-22 TinyTiM rev2 work in progress, schematic complete
    [Row_A.sch, Row_B.sch, Row_C.sch, Row_D.sch, Row_E.sch, Row_F.sch, Row_G.sch, Row_H.sch]
2014-05-23 TinyTiM rev2 complete. Uses WS2812B 4 pin RGB LED
    [TinyTIM_BoM_pcb.csv, TinyTIM_BoM_sch.csv, TinyTIM_BoM_seeed.xls, TinyTiM.kicad_pcb, TinyTiM_BoM.ods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]
2014-06-17 add test fixture code for TinyTIM
    [TinyTimTest.ino]
2014-12-18 TinyTiM files verified. rev2 looks good to go
    [Male_Header_2x8.stl, Row_A.sch, Row_B.sch, Row_C.sch, Row_D.sch, Row_E.sch, Row_F.sch, Row_G.sch]
2014-12-19 TinyTiM, regenerated Gerbers after minor cleanup.
    [Row_A.sch, Row_B.sch, Row_C.sch, Row_D.sch, Row_E.sch, Row_F.sch, Row_G.sch, Row_H.sch]
2015-01-14 BoM update
    [PCB Technology Requirement Format V1 for TinyTim.xlsx, TinyTIM_rev2_BoM_seeed_2.xls, TinyTIM_rev2_BoM_seeed_v3.xls, TinyTiM.kicad_pcb]
2015-03-13 added images for User guide
    [TinyTiM (copy).kicad_pcb]
2015-04-05 TinyTiM rev3 WIP. Transparent version
    [PCB Technology Requirement Format V1 for TinyTim_rev3.xlsx, Row_A.sch, Row_B.sch, Row_C.sch, Row_D.sch, Row_E.sch, Row_F.sch, Row_G.sch]
2015-04-05 TinyTiM rev3 WIP. Transparent version, BoM modified
    [TinyTIM_rev3_BoM_seeed.xls]
2015-04-06 TinyTiM_rev3 some minor mods for 3D render
    [TinyTiM.kicad_pcb]
2015-04-17 added Data, 5V and GND to mounting holes for pass thru no wire connecitons
    [$Row_H.sch, Row_A.sch, Row_H.sch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]
2015-04-17 TinyTiM, transparent, no copper fill, Serial mode default, +5V-GND-DataIn-DataOut connections on screw connection holes
    [TinyTiM-B_Cu.gbl, TinyTiM-B_Mask.gbs, TinyTiM-B_Paste.gbp, TinyTiM-B_SilkS.gbo, TinyTiM-Edge_Cuts.gbr, TinyTiM-F_Cu.gtl, TinyTiM-F_Mask.gts, TinyTiM-F_Paste.gtp]
2016-02-14 work in progress, microTIM using APA102
    [$Row_H.sch, PCB Technology Requirement Format V1 for TinyTim_rev3.xlsx, Row_A.sch, Row_B.sch, Row_C.sch, Row_D.sch, Row_E.sch, Row_F.sch]
2016-02-15 microTiM aka uTiM work in progress
    [Cap_0805_2012.step, Cap_2917_AVX_D_CASE.step, LED_SMD_APA102.step, LED_SMD_APA102_2.step, PowerIn_Stud.fcstd, PowerIn_Stud.step, Row_A.sch, Row_B.sch]
2016-02-17 layout complete. Gerbers pending
    [$Row_H.sch, Row_A.sch, Row_B.sch, Row_C.sch, Row_D.sch, Row_E.sch, Row_F.sch, Row_G.sch]
